UA1ZDC/StepDrive/StepDrivePwr/SDP_v1.1/Project Outputs for SDP_2/Bill/SDP_BOM.xlsx

Description | Designator | Footprint | Quantity | Value | Part Number
SMD Capacitor | C1, C7, C8, C9, C10, C13, C14, C17, C25, C29, C31, C32, C33 | C0603 | 13 | 0.1uF | GCJ188R71H104KA12D
SMD Capacitor | C2 | C1210 | 1 | 4.7uF | GRM188R61C475ME11D
SMD Capacitor | C2, C20, C21, C22, C23, C39, C40, C41, C42 | C1210 | 8 | 4.7uF | GRM32DC72A475KE01K
SMD Capacitor | C3 | C1210 | 1 | 10uF | GCM32EL8EH106KA07L
SMD Capacitor | C4, C5, C6 | C0603 | 3 | 1uF | GRT188R61H105KE13D
SMD Capacitor | C11, C12, C15, C16, C18, C19 | C0603 | 6 | 5600pF | GRM1885C1H562JA01D
SMD Capacitor | C24, C28, C30 | C0603 | 3 | 2200pF | GRM1885C1H222JA01D
SMD Capacitor | C26, C27 | C0603 | 2 | 100pF | GRM1885C1H101JA01J
SMD Capacitor | C34 | C0603 | 1 | 4.7nF | GCM188R91H472KA37D
SMD Capacitor | C35 | C0603 | 1 | 130pF | GRM1885C1H131JA01D
SMD Capacitor | C36 | C0603 | 1 | 8.2nF | GRM1885C1H822JA01D
SMD Capacitor | C37, C43, C44 | C0603 | 3 | 0.01uF | GCM188R71H103KA37J
SMD Capacitor | C38 | C0603 | 1 | 2.2uF | GRM188R61E225KA12J
SMD Capacitor | С20, C45, C46, C47 | C1210 | 4 | 10uF | GRM32EC72A106KE05
 | DD1 | DDA | 1 |  | TPS54332DDA
Regulator | DD2 | SOT23-5 | 1 |  | LP2985-33DBVR
Gate driver | DD3, DD4, DD5, DD6, DD8 | SO8_L | 5 |  | LM5109BMA
EEPROM | DD7 | SO8_L | 1 |  | AT25128B-SSHL-T
Shunt amplifier | DD9, DD10, DD11 | MSOP8 | 3 |  | AD8418WBRZ | или INA240A1D
fuse block | FU2 | omni_block_154 | 1 |  | 0154010.DR
LED0603 | HL1, HL2, HL3 | LED0603 | 3 |  | APT1608CGCK | green LED indicator
chip inductor | L1 | XAL5050 | 1 |  | XAL5050-223ME
 | L2, L3, L4, L5 | R0603 | 4 | 600 | BLM18AG601BH1D
SMD Resistor | R1 | R0603 | 1 | 68k | ERJ-3EKF6802V
SMD Resistor | R2, R6, R14, R15, R16, R17, R24, R25, R26, R27, R30, R31, R46, R49 | R0603 | 14 | 10k | ERJ-3EKF1002V
SMD Resistor | R3, R7 | R0603 | 2 | 22k | ERJ-3EKF2202V
SMD Resistor | R4, R34, R39, R42, R45, R47 | R0603 | 6 | 1k | ERJ-3EKF1001V
SMD Resistor | R5, R32, R37 | R0603 | 3 | 100 | ERJ-3EKF1000V
SMD Resistor | R8, R9, R10, R11, R12, R13, R18, R19, R20, R21, R22, R23, R28, R29 | R0603 | 14 | 2r2 | ERJ-PA3J2R2V
SMD Resistor | R33, R38, R51, R52 | R0603 | 4 | 0 | ERJ-S030R00V
SMD Resistor | R35, R36, R40, R41, R43, R44 | R2512 | 6 | 0.015 | ERJ-M1WSF15MU
SMD Resistor | R48 | R0603 | 1 | 10k5 | ERJ-3EKF1052V
SMD Resistor | R50 | R0603 | 1 | 750 | ERJ-3GEYJ751V
Shottky diode | VD1 | SMA-DO214 | 1 |  | B320A-13-F
zener diode | VD2 |  |  |  | BZX384C4V7-E3-08
zener diode | VD8, VD9, VD10, VD11 | SOD323 | 4 |  | BZX384B13-E3-08
Shottky rectifier | VD3, VD4, VD5, VD6, VD7 | SOD-123 | 5 |  | SKL110
 | VD12 |  | 1 |  | SM15T68A
MOSFET-N | VT1, VT2, VT3, VT4, VT5, VT6, VT7, VT8, VT9 | TDSON-8 | 9 |  | BSC030N08NS5ATMA1
pcb terminal | X1 | IDC-30(BH-30) | 1 |  | BH-30
pcb terminal | X2, X3 | 15EDGRC | 2 |  | ECH381RR-04P | 15EDGRC-3.81-04P
cable terminal |  |  | 2 |  | EC381V-04P | 15EDGK-3.81-04P
pcb terminal | X4 | DG308-2.54-2 | 1 |  | EK254V-02P
