UA1ZDC/StepDrive/StepDriveCont/SDC_v1.1/Docs/SDC_v1.1_Bill.xlsx

№ n/n | Type | Comment | Description | Designator | LibRef | Footprint | Name | PartNumber | Quantity | Value | Voltage
1 | Ceramic Capacitor | CAP | SMD Capacitor | C1, C10, C11, C12, C13, C14, C15, C16, C17, C18, C19, C20, C21, C22, C23, C24, C25, C26, C28, C31, C32, C33, C36, C37, C38, C39, C40, C41, C43, C46, C47, C48, C49, C50, C52, C53, C54, C55, C56, C57, C58, C59, C60, C61, C62, C63, C64, C66, C67, C70, C71, C79, C80, C81, C82, C86, C94, C96, C97, C98, C99, C100 | CAP | C0603 |  |  | 62 | 0.1uF | 50V
2 | Ceramic Capacitor | CAP | SMD Capacitor | C2, C9 | CAP | C0603 |  | GRM188R61A475KE15D | 2 (9шт) | 4.7uF | 10V
3 | Aluminum | KR-5R5H155-R | Ionistor | C3 | KR-5R5H155-R | KR-5R5H155-R |  |  | 1 | 1.5F | 5V
4 | Ceramic Capacitor | CAP | SMD Capacitor | C4 | CAP | C0603 |  |  | 1 | 10nF | 10V
5 | Ceramic Capacitor | CAP | SMD Capacitor | C5, C6 | CAP | C0603 |  |  | 2 | 2.2uF | 50V
6 | Ceramic Capacitor | CAP | SMD Capacitor | C7, C8, C34, C35 | CAP | C0603 |  |  | 4 | 5.6pF | 50V
7 | Ceramic Capacitor | CAP | SMD Capacitor | C27, C42, C44 | CAP | C0603 |  |  | 3 | 4.7uF | 50V
8 | Ceramic Capacitor | CAP | SMD Capacitor | C29 | CAP | C0603 |  |  | 1 | 1nF | 50V
9 | Ceramic Capacitor | CAP | SMD Capacitor | C30, C65 | CAP | C0603 |  |  | 2 | 1uF | 50V
10 | Ceramic Capacitor | CAP | SMD Capacitor | C45, C51 | CAP | C1206 |  |  | 2 | 47uF | 10V
11 | Ceramic Capacitor | CAP | SMD Capacitor | C68, C69 | CAP | C0603 |  |  | 2 | NC | 10V
12 |  | caseD | Polarized Capacitor (Surface Mount) | C72, C73, C92, C93 | Cap Pol_D | Cap_D |  |  | 4 | 22uF | 35V
13 | Ceramic Capacitor | CAP | SMD Capacitor | C74, C75 | CAP | C1210 |  |  | 2 | 10uF | 50V
14 | Ceramic Capacitor | CAP | SMD Capacitor | C76 | CAP | C0603 |  |  | 1 | 10nF | 50V
15 | Ceramic Capacitor | CAP | SMD Capacitor | C77, C84, C95 | CAP | C1210 |  |  | 3 | 10uF | 10V
16 | Ceramic Capacitor | CAP | SMD Capacitor | C78, C85 | CAP | C1210 |  |  | 2 | 47uF | 10V
17 | Ceramic Capacitor | CAP | SMD Capacitor | C83 | CAP | C0603 |  |  | 1 | 0.47uF | 50V
18 | Ceramic Capacitor | CAP | SMD Capacitor | C87, C101 | CAP | C0805 |  |  | 2 | 10uF | 50V
19 | Ceramic Capacitor | CAP | SMD Capacitor | C88, C102 | CAP | C1210 |  |  | 2 | 22uF | 25V
20 | Ceramic Capacitor | CAP | SMD Capacitor | C89, C103 | CAP | C0603 |  |  | 2 | 4.7nF | 50V
21 | Ceramic Capacitor | CAP | SMD Capacitor | C90, C104 | CAP | C0603 |  |  | 2 | 130pF | 50V
22 | Ceramic Capacitor | CAP | SMD Capacitor | C91, C105 | CAP | C0603 |  |  | 2 | 8.2nF | 50V
23 |  | USBLC6 | ESD protection Very low capacitance | DA1 | USBLC6-4SC6 | ESD_SOT23-6L |  | USBLC6-4SC6Y | 1 (3шт)
24 |  | STM32H743ZxT | ARM Cortex-M7, 480MHz, 32-bit MCU+FPU, 144-pin LQFP | DD1 | STM32H743ZxT | STM-LQFP144_L |  | STM32H743ZIT6U | 1 (2шт)
25 |  | SIM68V | GPS module | DD2 | SIM68V | SIM68M |  |  | 1
26 |  | LIS3DH | Accelerometer | DD3 | LIS3DH | LGA-16 |  |  | 1
27 |  | KXO-V97 | KXO generator | DD4, DD5 | KXO-V97 | SO4-GEN |  |  | 2
28 |  | LAN8742A | RMII 10/100 Ethernet PHY | DD6 | LAN8742A | QFN-MJ24 |  | LAN8742A-CZ | 1 (3 шт)
29 |  | 74HC245PWR, 74LVC45APWR |  | DD7, DD9 | 74HC245PWR, 74LVC45APWR | TSSOP20 |  |  | 2
30 |  | ADM2587E | RS485 isolator | DD8 | ADM2587E | SOIC_20W |  |  | 1
31 |  | STM3485 | RS485_tranciever | DD10 | ST3485EB | SO8_L |  |  | 1
32 |  | TMC4671 | Motion_controller | DD11, DD12 | TMC4671 | QFN76 |  |  | 2
33 |  | Si8660BA-IS, AM26C31CD, AM26LV32ID, 74HC257 | digital isolator, RS-422 transmitter, RS-422 receiver, MUX | DD13, DD15, DD17, DD18, DD19 | Si8660BA-IS, AM26C31CD, AM26LV32ID, 74HC257 | SO-16_N |  |  | 5
34 | Industrial eFuse | TPS26600RHFR | Industrial eFuse | DD14 | TPS26600RHFR | VQFN24 | TPS26600 |  | 1 |  | 60V
35 |  | LM26420X |  | DD16 | LM26420X | WQFN16 |  |  | 1
36 |  | TPS54332 |  | DD20, DD21 | TPS54332 | DDA |  |  | 2
37 |  | TBU-CA065 | TBU fuse | F1, F2, F3, F4, F5, F6 | TBU-CA065 | TBU-CA |  |  | 6
38 |  | 0154010 | omni fuse block | FU1 | 0154010 | omni_block_154 |  |  | 1
39 |  | 2030-42T-SM | Charger | FV1, FV2, FV3 | 2030-42T-SM | 2030-42T-SM |  |  | 3
40 |  | LED0603 | LED0603 | HL1, HL2, HL3, HL4, HL5 | LED0603 | LED0603 |  |  | 5
41 |  | JUMP |  | J1, J2 | JUMP | JUMP |  |  | 2
42 |  | LQH32CN | chip inductor | L1, L3, L4 | LQH32CN | LQH32CN |  |  | 3 | 1uH
43 |  | FerriteBead | SMD Chip ferrite bead 0603 | L2 | FerriteBead | L0603 |  |  | 1 | 600R
44 |  | BLM18AG |  | L5 | BLM18AG | R0603 |  |  | 1 | 600
45 |  | XAL6060 | chip inductor | L6 | XAL6060 | XAL6060 |  |  | 1
46 |  | XAL4030 | chip inductor | L7, L8 | XAL4030 | XAL4030 |  |  | 2 | 3.3uH
47 |  | XAL5050 | chip inductor | L9, L10 | XAL5050 | XAL5050 |  |  | 2 | 5.1uH
48 |  | NX2016SA | Crystal oscillator 25MHz | Q1 | NX2016SA | CRY_NX2016SA_4P |  | NX2016SA | 1 (6шт) | 25MHz
49 |  | RES | SMD Resistor | R1, R2, R3, R4, R8, R16, R21, R22, R23, R30, R31, R37, R38, R39, R40, R41, R42, R45, R46, R47, R48, R49, R50, R51, R52 | RES | R0603 | Chip SMD Resistor | RC0603FR-0710KL | 25 (9шт) | 10k
50 |  | RES | SMD Resistor | R5, R6, R7, R24, R65, R66 | RES | R0603 | Chip SMD Resistor |  | 6 | 1k5
51 |  | RES | SMD Resistor | R9 | RES | R0603 | Chip SMD Resistor |  | 1 | 27k
52 |  | RES | SMD Resistor | R10, R11, R12, R55, R61, R64 | RES | R0603 | Chip SMD Resistor |  | 6 | 1k
53 |  | RES | SMD Resistor | R13, R14, R15, R25, R26, R27, R34 | RES | R0603 | Chip SMD Resistor |  | 7 | 33
54 |  | RES | SMD Resistor | R17, R18, R19, R20 | RES | R0603 | Chip SMD Resistor |  | 4 | 51
55 |  | RES | SMD Resistor | R28, R43, R44, R72, R73, R74, R75, R76 | RES | R0603 | Chip SMD Resistor | RC0603JR-070RL | 8 (162) | 0 | не уверена
56 |  | RES | SMD Resistor | R29 | RES | R0603 | Chip SMD Resistor |  | 1 | 12k1
57 |  | RES | SMD Resistor | R32, R33 | RES | R0603 | Chip SMD Resistor |  | 2 | 270
58 |  | RES | SMD Resistor | R35, R36 | RES | R0603 | Chip SMD Resistor | RC0603FR-07100KL | 2 (12шт) | 100 | не уверена
59 |  | RES | SMD Resistor | R53 | RES | R0603 | Chip SMD Resistor |  | 1 | 221k
60 |  | RES | SMD Resistor | R54 | RES | R0603 | Chip SMD Resistor |  | 1 | 8k87
61 |  | RES | SMD Resistor | R56, R60, R63, R69, R78 | RES | R0603 | Chip SMD Resistor |  | 5 | 10k2
62 |  | RES | SMD Resistor | R57 | RES | R0603 | Chip SMD Resistor |  | 1 | 6k04
63 |  | RES | SMD Resistor | R58 | RES | R0603 | Chip SMD Resistor |  | 1 | 5.1
64 |  | RES | SMD Resistor | R59 | RES | R0603 | Chip SMD Resistor |  | 1 | 31k6
65 |  | RES | SMD Resistor | R62 | RES | R0603 | Chip SMD Resistor |  | 1 | 5k1
66 |  | RES | SMD Resistor | R67 | RES | R0603 | Chip SMD Resistor |  | 1 | 665k
67 |  | RES | SMD Resistor | R68, R77 | RES | R0603 | Chip SMD Resistor |  | 2 | 9k31
68 |  | RES | SMD Resistor | R70 | RES | R0603 | Chip SMD Resistor |  | 1 | 316k
69 |  | RES | SMD Resistor | R71 | RES | R0603 | Chip SMD Resistor |  | 1 | 1k96
70 |  | RES | SMD Resistor | R79 | RES | R0603 | Chip SMD Resistor |  | 1 | 750
71 |  | Test_point |  | TP1, TP2, TP3, TP4, TP5, TP6, TP7, TP8, TP9, TP10, TP11, TP12, TP13, TP14, TP15, TP16, TP17, TP18, TP19, TP20, TP21, TP22, TP23, TP24 | TP | TP1 |  |  | 24
72 |  | SMBJ | TVS diode, TVSdiode | VD1, VD2, VD3, VD4, VD5, VD6, VD7, VD8, VD9 | SMBJ5CA, SMBJ12CA | SMB-DO214 |  |  | 9
73 |  | B550C | DIODE, SCHOTTKY, 5A, 50V, SMC | VD10 | B550C | SMC-DO214 |  |  | 1
74 |  | ESDA6V1SC6, ESDA5V3SC6 | 4-line ESD protection | VD11, VD12, VD13, VD14, VD16, VD17, VD18, VD19 | ESDA6V1SC6, ESDA5V3SC6 | SOT23-6 |  | USBLC6-2SC6Y | 8 (3 шт) |  | не уверена
75 |  | B320A | Shottky diode | VD15, VD20 | B320A | SMA-DO214 |  |  | 2
76 |  | IRLML2803 | n-channel fet | VT1, VT2 | IRLML2803 | SOT23 |  | BSR14 | 2 (12 шт)
77 |  | BH-20 |  | X1 | IDC10x2_GOST | IDC-20(BH-20) |  |  | 1
78 |  | MMCX | Coaxial | X2 | MMCX | MMCX |  |  | 1
79 |  | HR911105A |  | X3 | HR911105A | HR911105A |  |  | 1
80 |  | DG141V-6P | wire connector | X4, X9, X10, X11, X12, X13, X14 | DG141V-6P | DG141V-06P |  |  | 7
81 |  | DG141V-12P | wire connector | X5 | DG141V-12P | DG141V-12P |  |  | 1
82 |  | BH-30 |  | X6, X7 | IDC15x2_GOST | IDC-30(BH-30) |  |  | 2
83 |  | DG142V-02 |  | X8 | DG142V-02 | DG142V-02 |  |  | 1
84 |  | FC-12M | Crystal_32_768 | Z1 | FC-12M | FC-12M |  |  | 1
