UA1ZDC/StepDrive/StepDrivePwr/SDP_v1.1/SDP.PcbDoc.htm

Reporting Options

# File in Previous Format

Date | : | 08.12.2022
Time | : | 16:05:46
Filename | : | D:\Altium_Projects\StepDrive\StepDrivePwr\SDP_v1.1\SDP.PcbDoc

Version | Warning

This file was generated by an earlier version of the software
