UA1ZDC/StepDrive/StepDriveCont/SDC_v1.1/SDC.PcbDoc.htm

Reporting Options

# File in Previous Format

Date | : | 08.12.2022
Time | : | 15:32:59
Filename | : | D:\Altium_Projects\StepDrive\StepDriveCont\SDC_v1.1\SDC.PcbDoc

Version | Warning

This file was generated by an earlier version of the software
