UA1ZDC/StepDrive/StepDriveCont/SDC_v1.1/Docs/KRJ-CB4.2GYZNL.docx

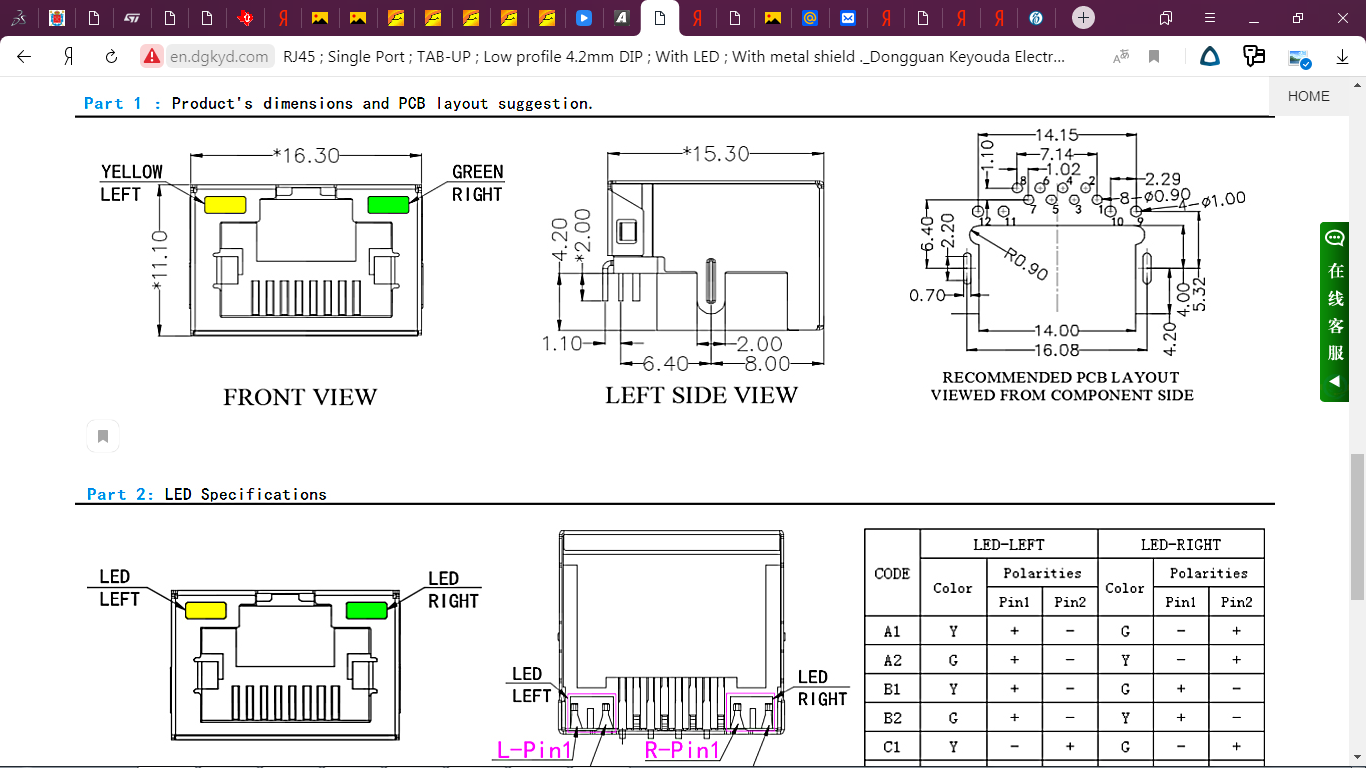
[picture p1: figure]
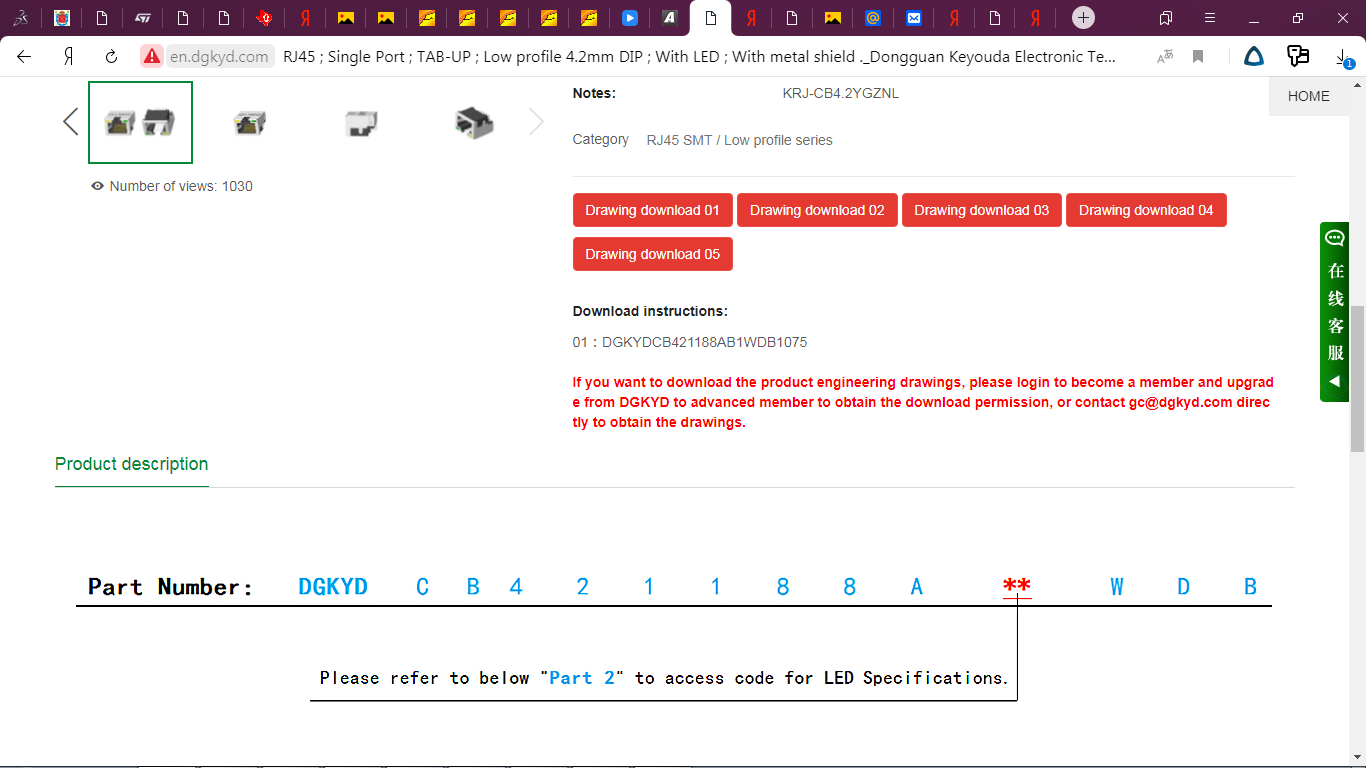
[picture p2: figure]
