UA1ZDC/StepDrive/StepDriveCont/SDC_v1.0/SDC.PcbDoc.htm

Reporting Options

# File in Previous Format

Date | : | 13.01.2022
Time | : | 19:52:07
Filename | : | D:\Altium_Projects\StepDrive\StepDriveCont\SDC.PcbDoc

Version | Warning

This file was generated by an earlier version of the software
