UA1ZDC/StepDrive/StepDriveCont/SDC_v1.0/Project Outputs for SDC/Бланк заказа.xlsx

Резонит тел. +7-495-777-80-80 e-mail: pcb@rezonit.ru
Название фирмы (или ФИО) заказчика |  |  |  |  | Овчинников Юрий Дмитриевич
Тип собственности плательщика |  |  |  |  | Физическое лицо
ФИО плательщика (если различно с заказчиком)
Серия, номер паспорта. Кем и когда выдан
Способ отправки счета |  |  |  |  | Электронная почта |  |  |  |  |  | email | yurii_ovchinniko@mail.ru
Способ получения плат |  |  |  |  | Самовывоз из офиса в Санкт-Петербурге
Способ доставки |  |  |  |  | необходимо заполнить
Адрес доставки заказа, примечания по доставке |  |  |  |  | необходимо заполнить
Контакт по доставке (ФИО, email, тел) |  |  |  |  | Овчинников Юрий Дмитриевич, yurii_ovchinniko@mail.ru, +7 (981) 197-43-18
Контакт по техническим вопросам (ФИО, email, тел) |  |  |  |  | Конюшенко Игорь Олегович, igorek1980@mail.ru, +7 (921) 932-28-17
Характеристика проекта |  |  |  |  | поля заполнены типовыми значениями, при необходимости можете изменить их
Название файла платы: |  |  |  |  | SDС |  |  |  |  |  | Срок производства ОПП и ДПП без маски — 2 рабочих дня, с маской — 3 дня. Срок производства многослойных печатных плат – 5-7 рабочих дней 1. Наличие электротестирования, иммерсионного золочения, нестандартной паяльной маски увеличивает срок изготовления на 1—2 рабочих дня. 2. Дни приема и доставки заказа не учитываются. 3. Изготовление плат по 5-му классу точности добавляет к сроку изготовления 1—2 рабочих дня. Отдельно оплачивается: • Иммерсионное золочение и иммерсионное сереберение • Нестандартная (черная, красная, синяя или супербелая) защитная маска +1500 руб. • Покрытие ламелей: Au — 0,30 руб./мм², Ni — 0,05 руб./мм². • Проверка платы электротестовым оборудованием на КЗ и обрыв — 40 руб./дм². • Изготовление и электротестирование 1 дм² МПП плат с параметрами зазор и/или проводник менее 0,2 мм, и/или минимальное переходное отверстие менее 0,4 мм, коэффициент = 1,2. • Изготовление и электротестирование 1 дм² ДПП с параметрами зазор и/или проводник менее 0,15 мм, и/или минимальное переходное отверстие менее 0,3 мм, коэффициент = 1,5.
Плата изготавливается: "впервые" / "повторно" |  |  |  |  | впервые
Вариант изготовления |  |  |  |  | Срочное производство
Требуется изготовить, шт |  |  |  |  | 2
Количество проводящих слоев |  |  |  |  | 4
Материал основания |  |  |  |  | FR4 типовой
Толщина материала (ОПП, ДПП)/Общая толщина платы ( МПП), мм |  |  |  |  | 1.50
Толщина фольги, мкм |  |  |  |  | 18
Финишное покрытие площадок |  |  |  |  | ПОС-63
Наличие маски |  |  |  |  | маска с 2 сторон |  |  | зеленого(типового)цвета
Наличие маркировки краской |  |  |  |  | с 2 сторон |  |  | белого(типового)цвета
Монтаж печатных плат |  |  |  |  | не требуется
Дополнительные требования
Перечень технологических слоев |  |  |  |  | поля заполнены типовыми значениями, при необходимости можете заполнить
 |  | Имя Gerber файла_Layer name (PCAD200x)_Слои в PCAD4.5(8.5)_DipTrace |  |  | Типовая сборка |  |  | Требуемая сборка |  | сверловка, укажите цветом начальный и конечный слой
Контур платы |  | SDС.GKO
Маркировка элементов сверху |  | SDС.GTO |  |  |  |  |  |  |  | Сквозные металлизированные отверстия | Сквозные неметаллизированные отверстия
Маска верхнего слоя |  | SDС.GTS
Верхний слой |  | SDС.GTL |  |  | фольга 18мкм
Внутренний
Внутренний
Внутренний
Внутренний |  | SDС.G1 |  |  | фольга 18мкм
Внутренний |  | SDС.G2 |  |  | фольга 18мкм
Внутренний
Внутренний
Внутренний
Нижний слой |  | SDС.GBL |  |  | фольга 18мкм
Маска нижнего слоя |  | SDС.GBS
Маркировка элементов снизу
PTH |  | SDС.txt
NPTH
Несквозные отверстия 1
Несквозные отверстия 2
Несквозные отверстия 3
Расширенные параметры печатной платы (сборка, мех. обработка и т.д) |  |  |  |  | поля заполнены типовыми значениями, при необходимости можете изменить их
Электротестирование
Покрытие краевых разъемов |  |  |  |  | соответствует финишному покрытию
Фаска 30грд на краевых разъемах
Мех обработка контура |  |  |  |  | На усмотрение производства
Металлизированный торец платы |  |  |  |  | Нет
Металлизированные полуотверстия
Металлизированные пазы
Структура МПП |  |  |  |  | типовая
Для PCAD4.5;8.5;2000 переходные |  |  |  |  | закрыты маской
Для экспорта шелкографии в PCAD200x мы используем след. настройки по умолчанию |  |  |  |  | RefDes | On | Type | Off | Value | Off
Панелизация |  |  |  |  | На усмотрение производтва
Размер платы (длина по горизонтали), мм |  |  |  |  | 100
Размер платы (ширина по вертикали), мм |  |  |  |  | 160
Количество плат по горизонтали
Количество плат по вертикали
Зазор между платами по горизонтали
Зазор между платами по вертикали
Размер полей по горизонтали
Размер полей по вертикали
Маркировка плат по ГОСТ
Описание PIN & VIA PCAD-4.5 и PCAD8.5.
Масштаб изготовления фотошаблона |  |  |  |  | 1:1
№ pin | Диаметр отверстия после металлизации | Размер контактной площадки | Форма контактной площадки | Наличие металлизации (по умолчению отверстия метализированы) | слои подключения (для многослоек)
