UA1ZDC/StepDrive/StepDriveCont/SDC_v1.1/Docs/HTB1oDgENVXXXXa2XXXXq6xXFXXXW.jpg

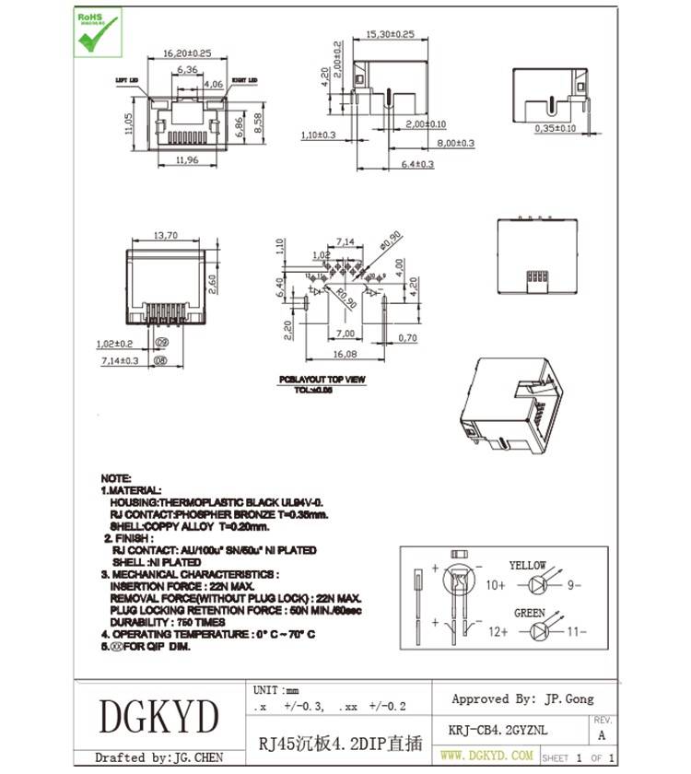
StepDriveCont/SDC_v1.1/Docs/HTB1oDgENVXXXXa2XXXXq6xXFXXXW.jpg
