UA1ZDC/StepDrive/StepDriveCont/SDC_v1.1/Docs/SDC_v1.1_assembly.PDF

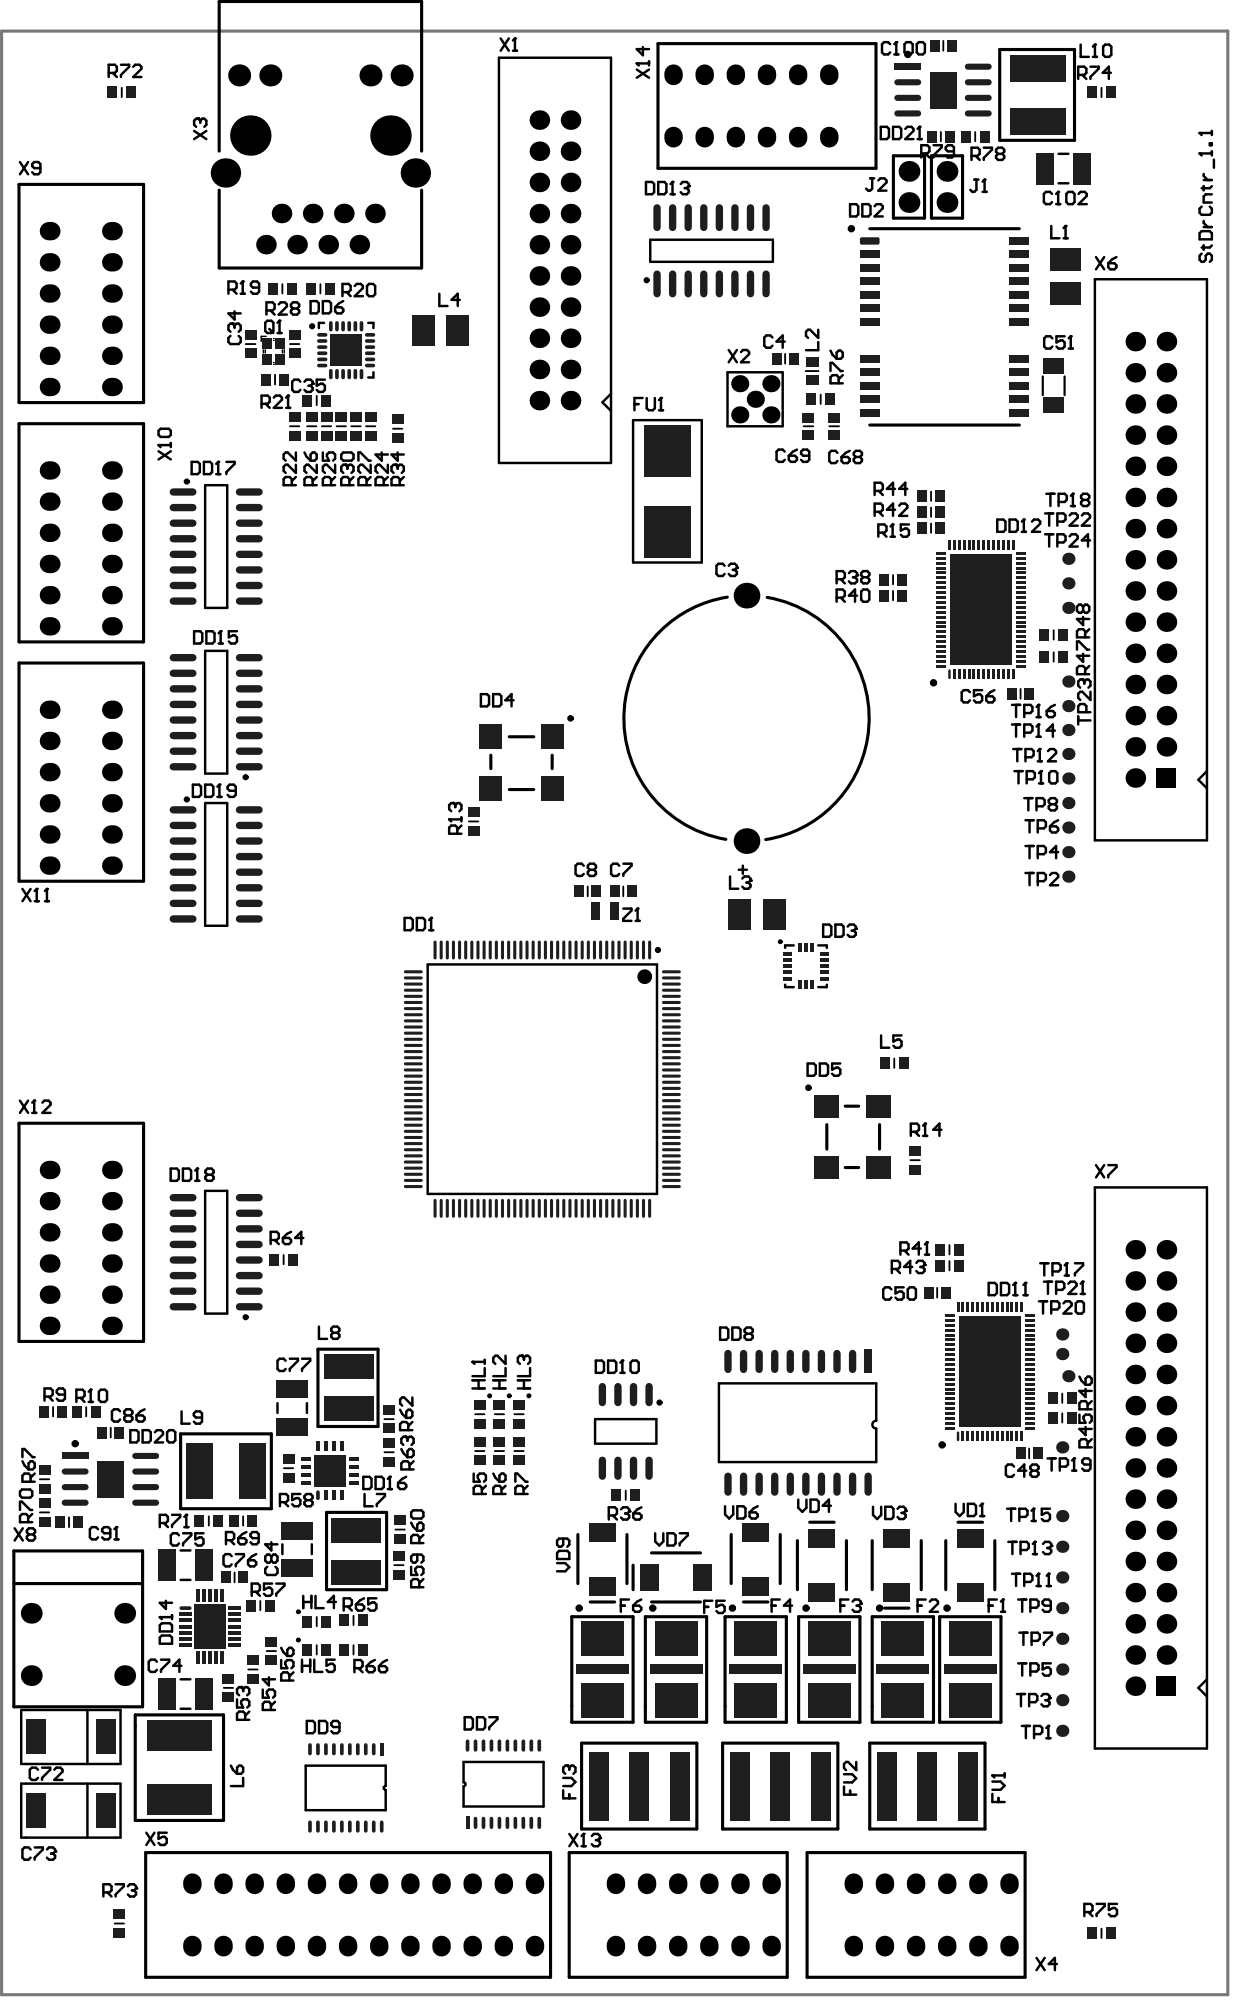
[picture p4: page 1]

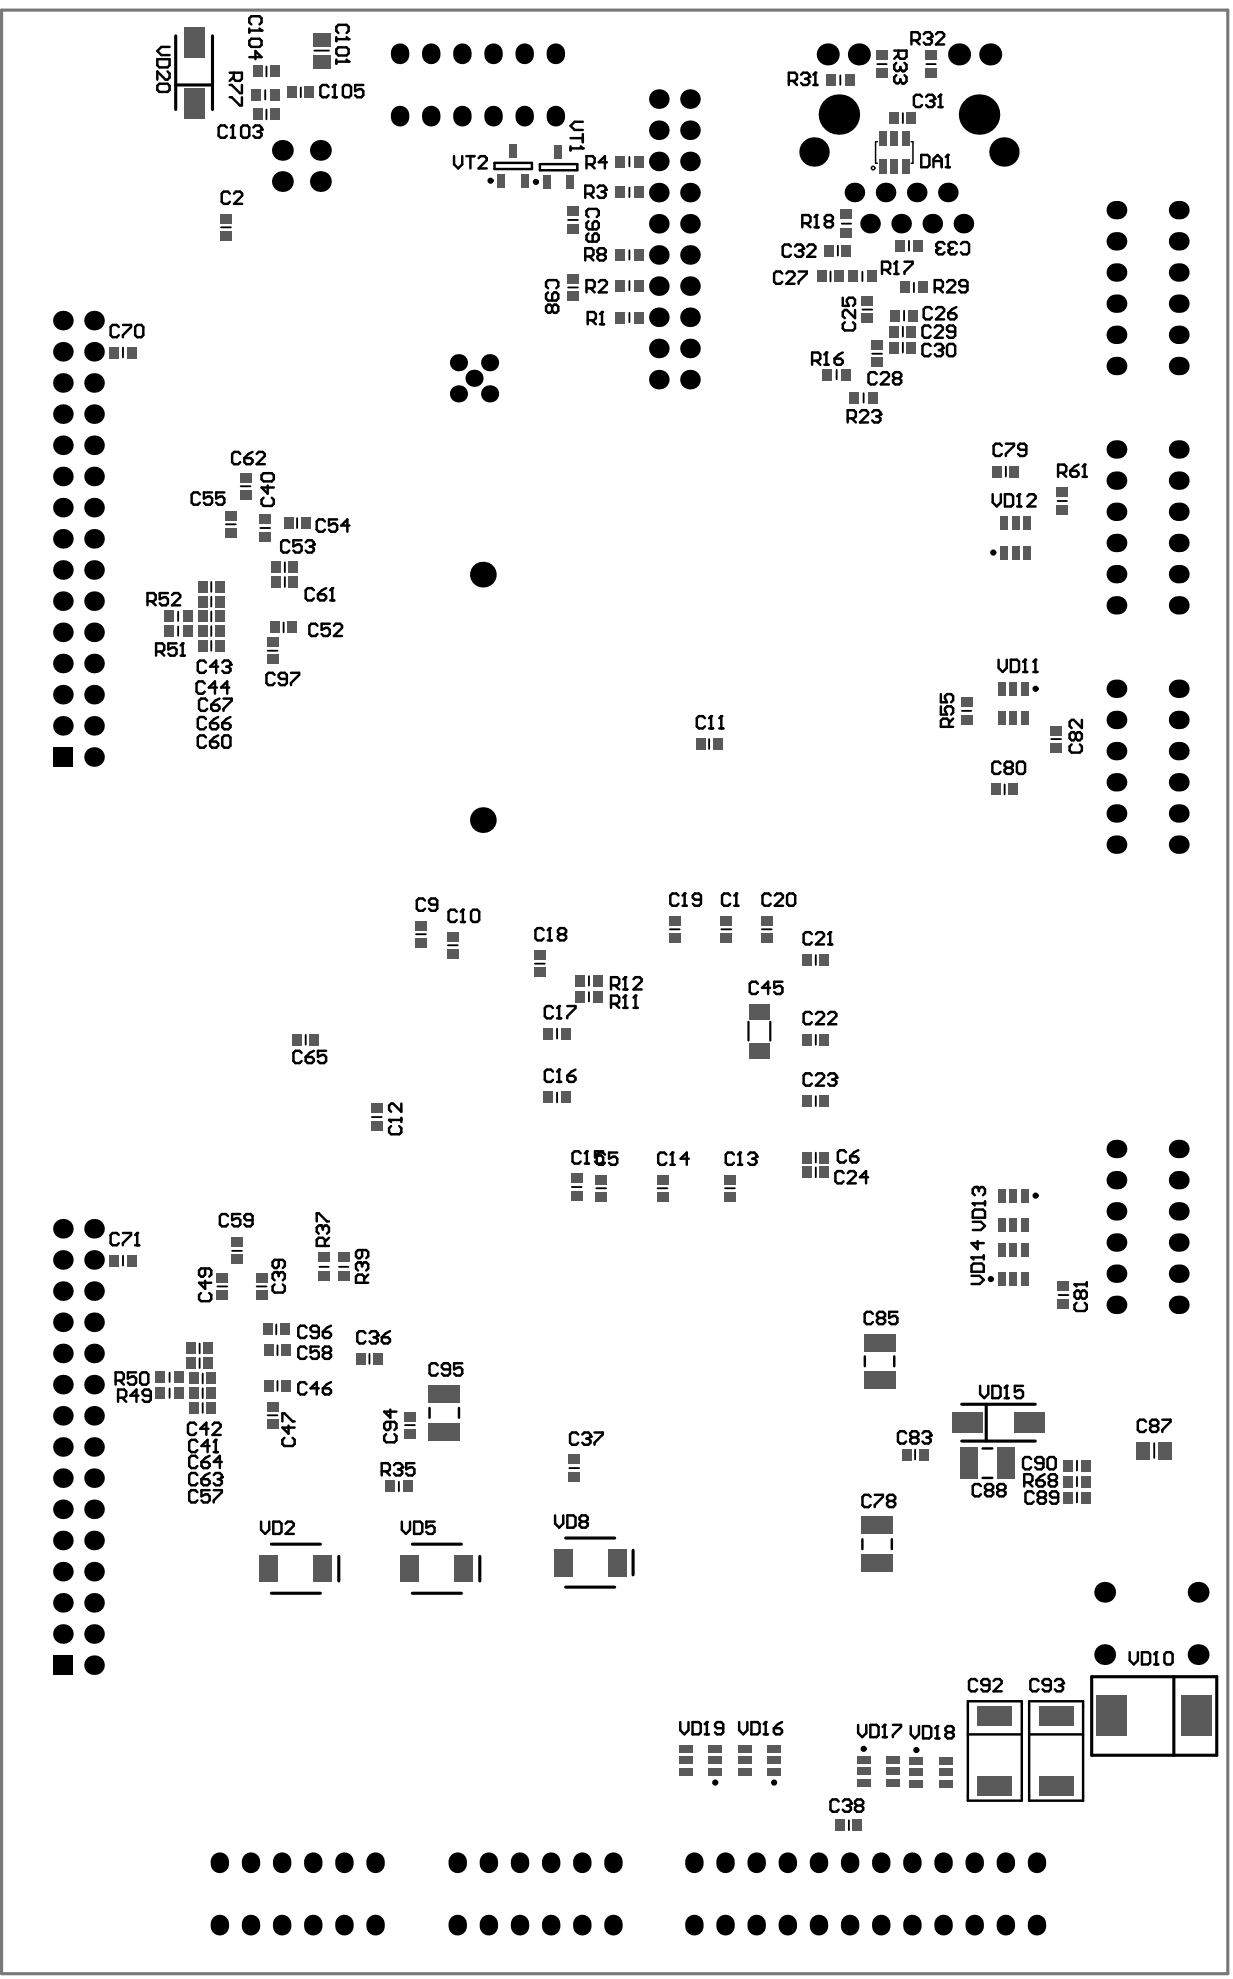
[picture p5: page 2]
