UA1ZDC/StepDrive/StepDrivePwr/SDP_v1.1/Project Outputs for SDP_2/PDF/StepPwr_v1.1_aseembly.PDF

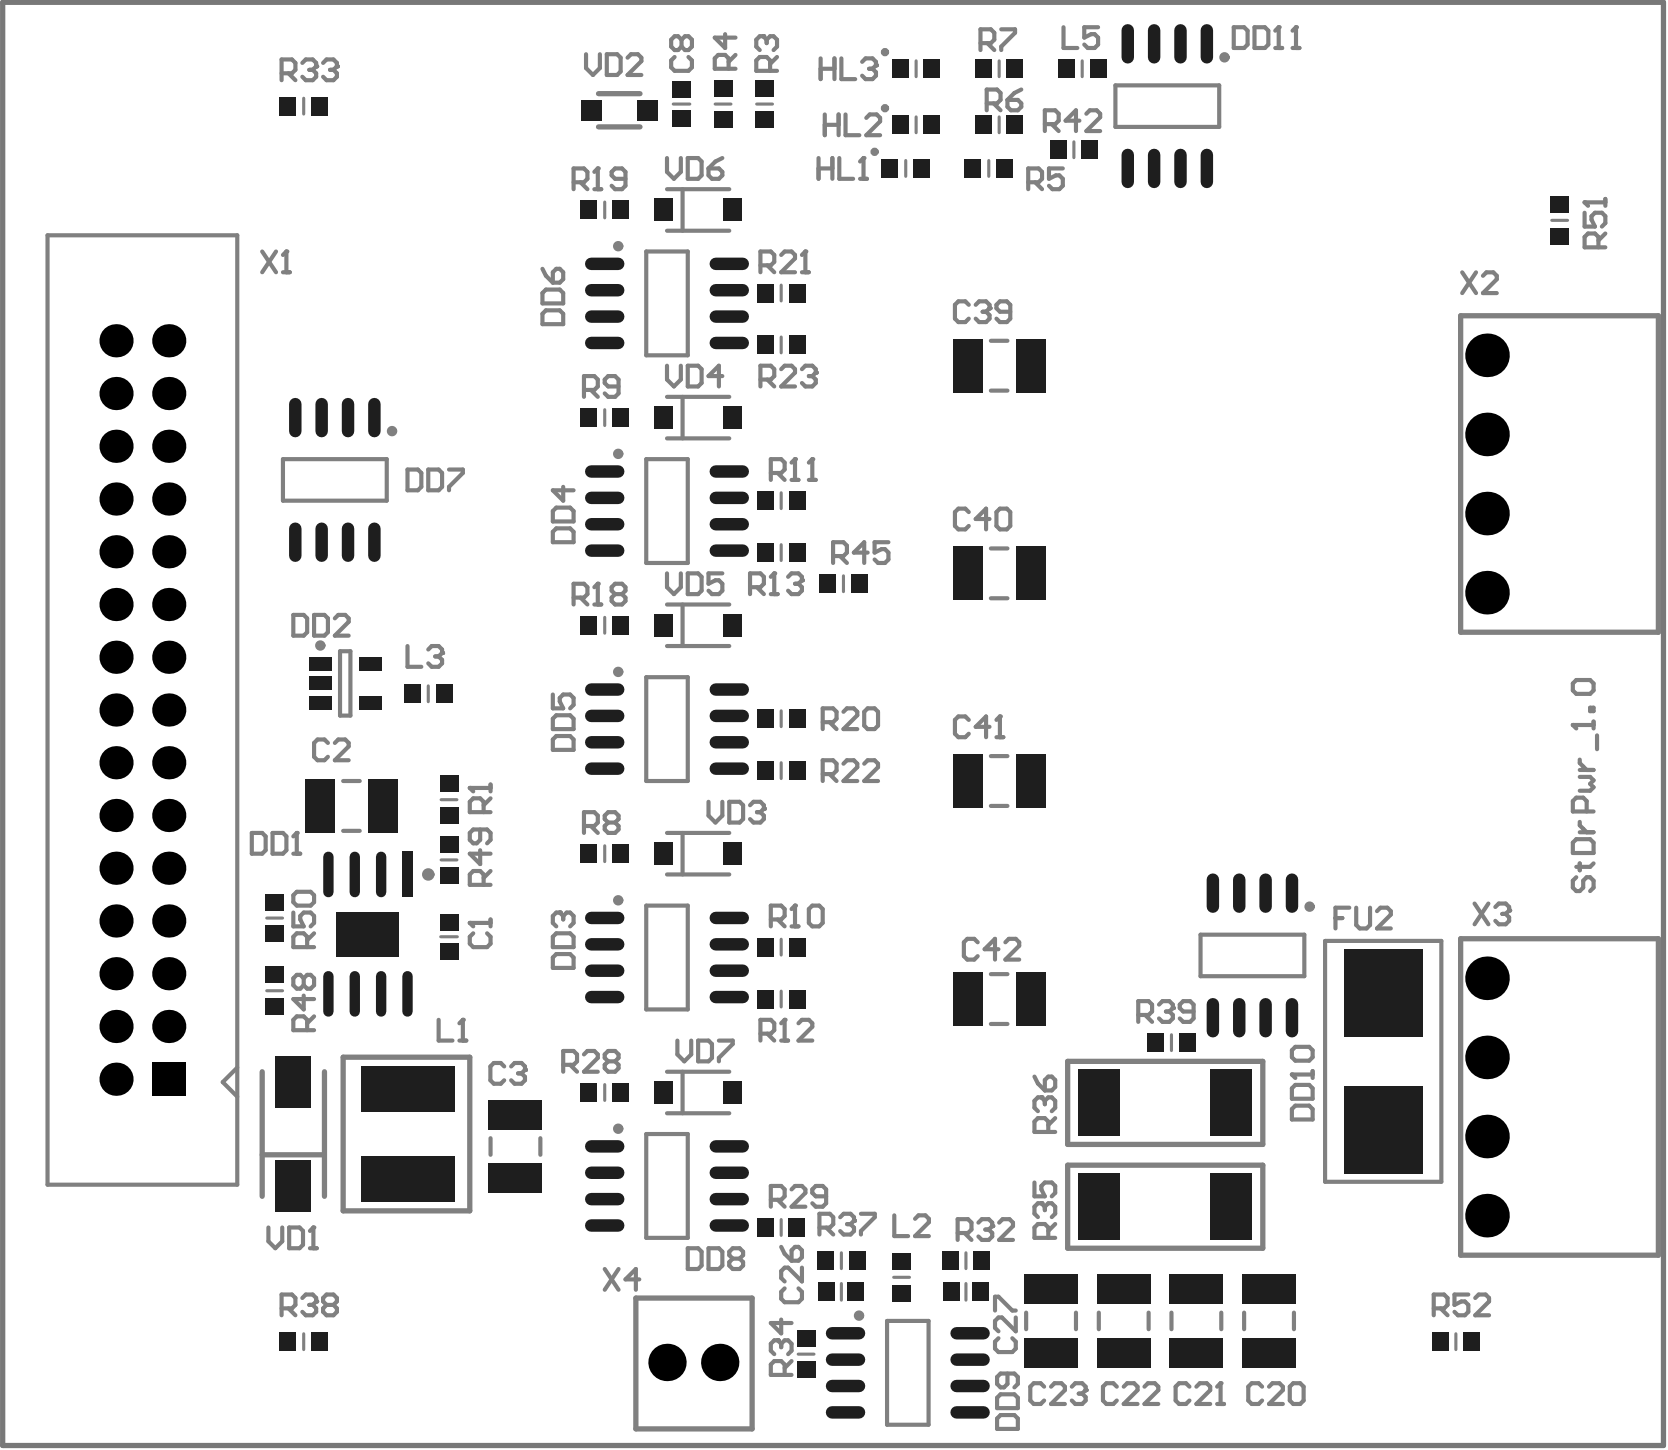
[picture p6: page 1]

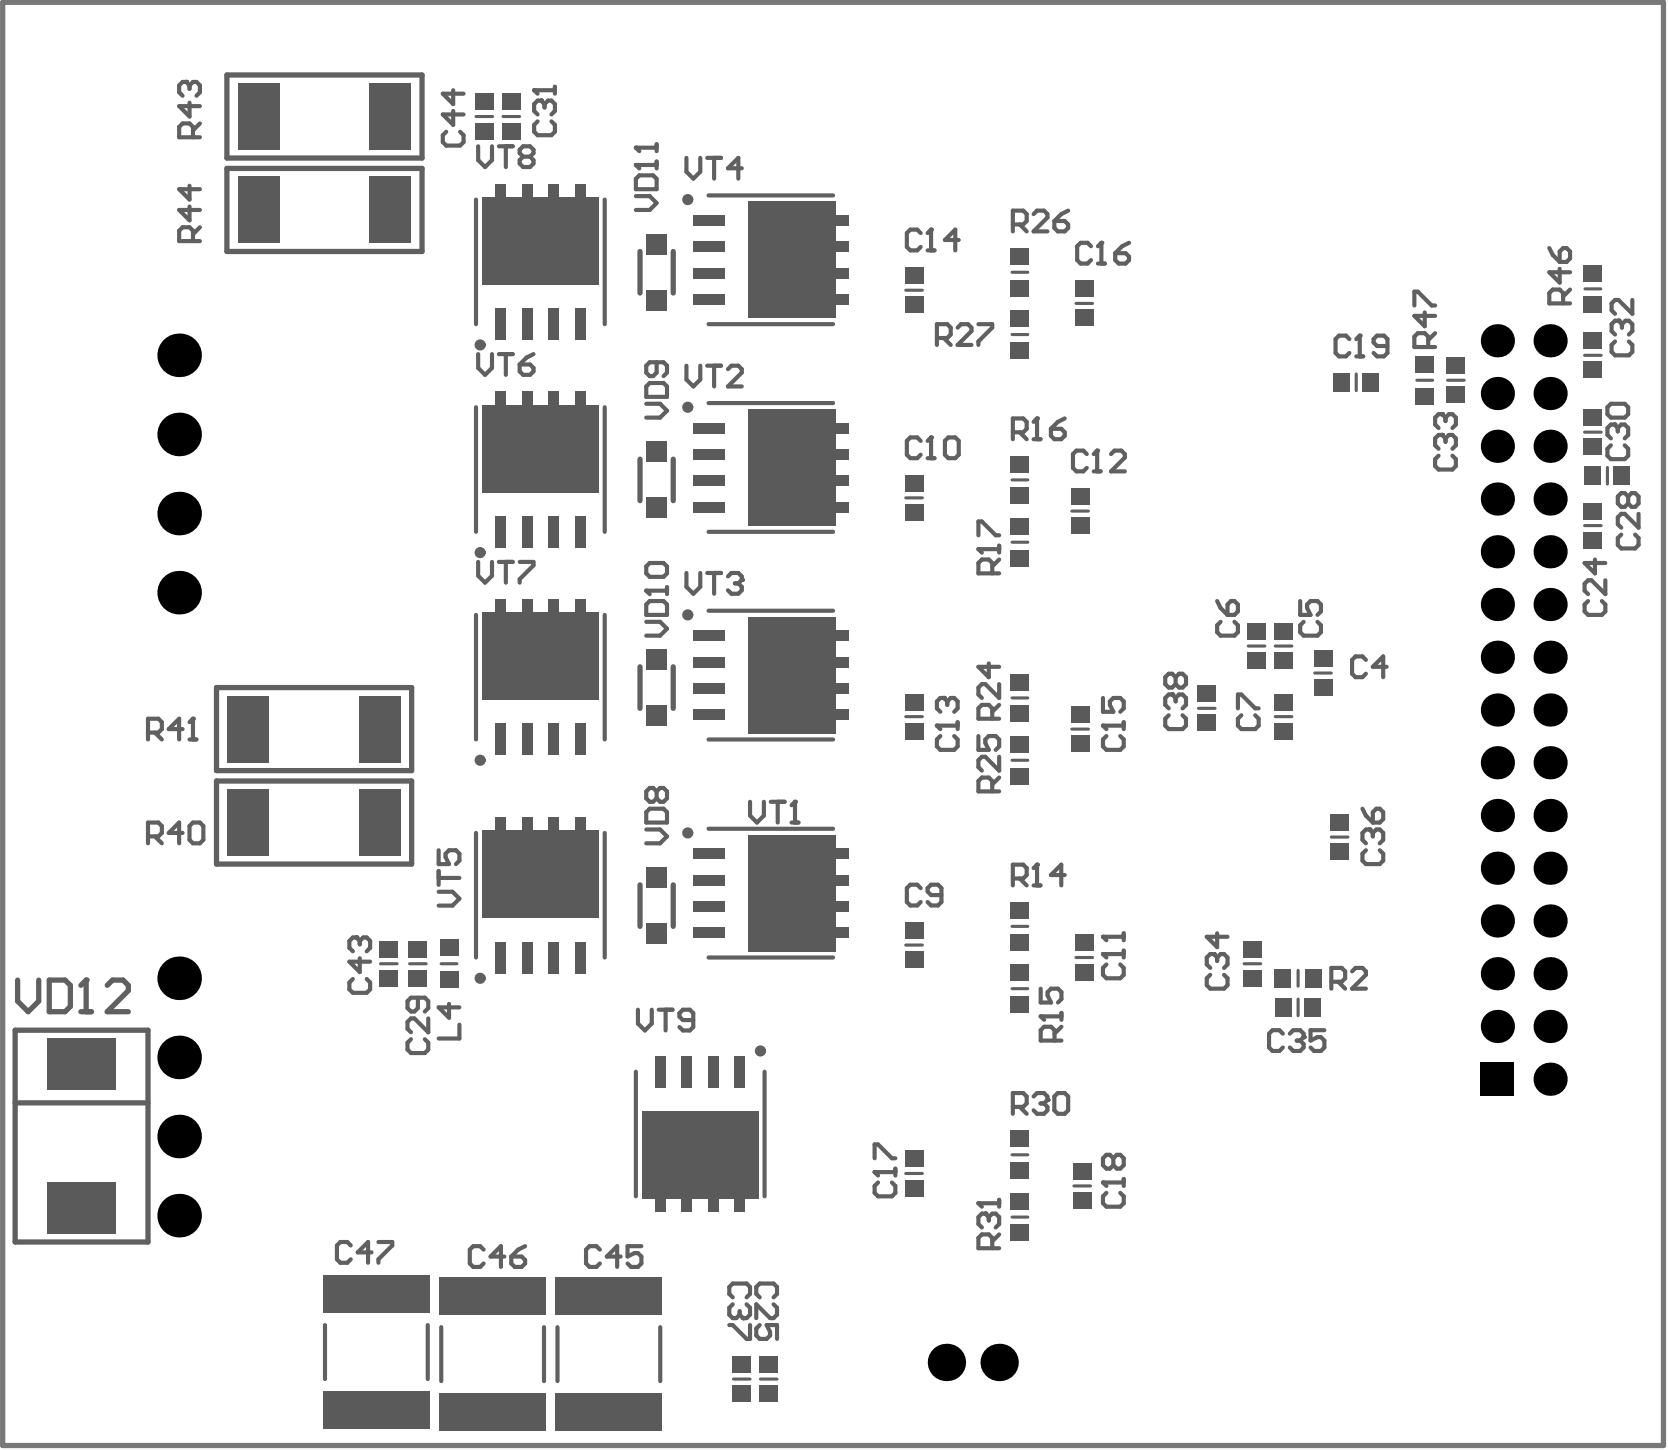
[picture p7: page 2]
