UA1ZDC/StepDrive/StepDrivePwr/SDP_v1.0/SDP.pdf

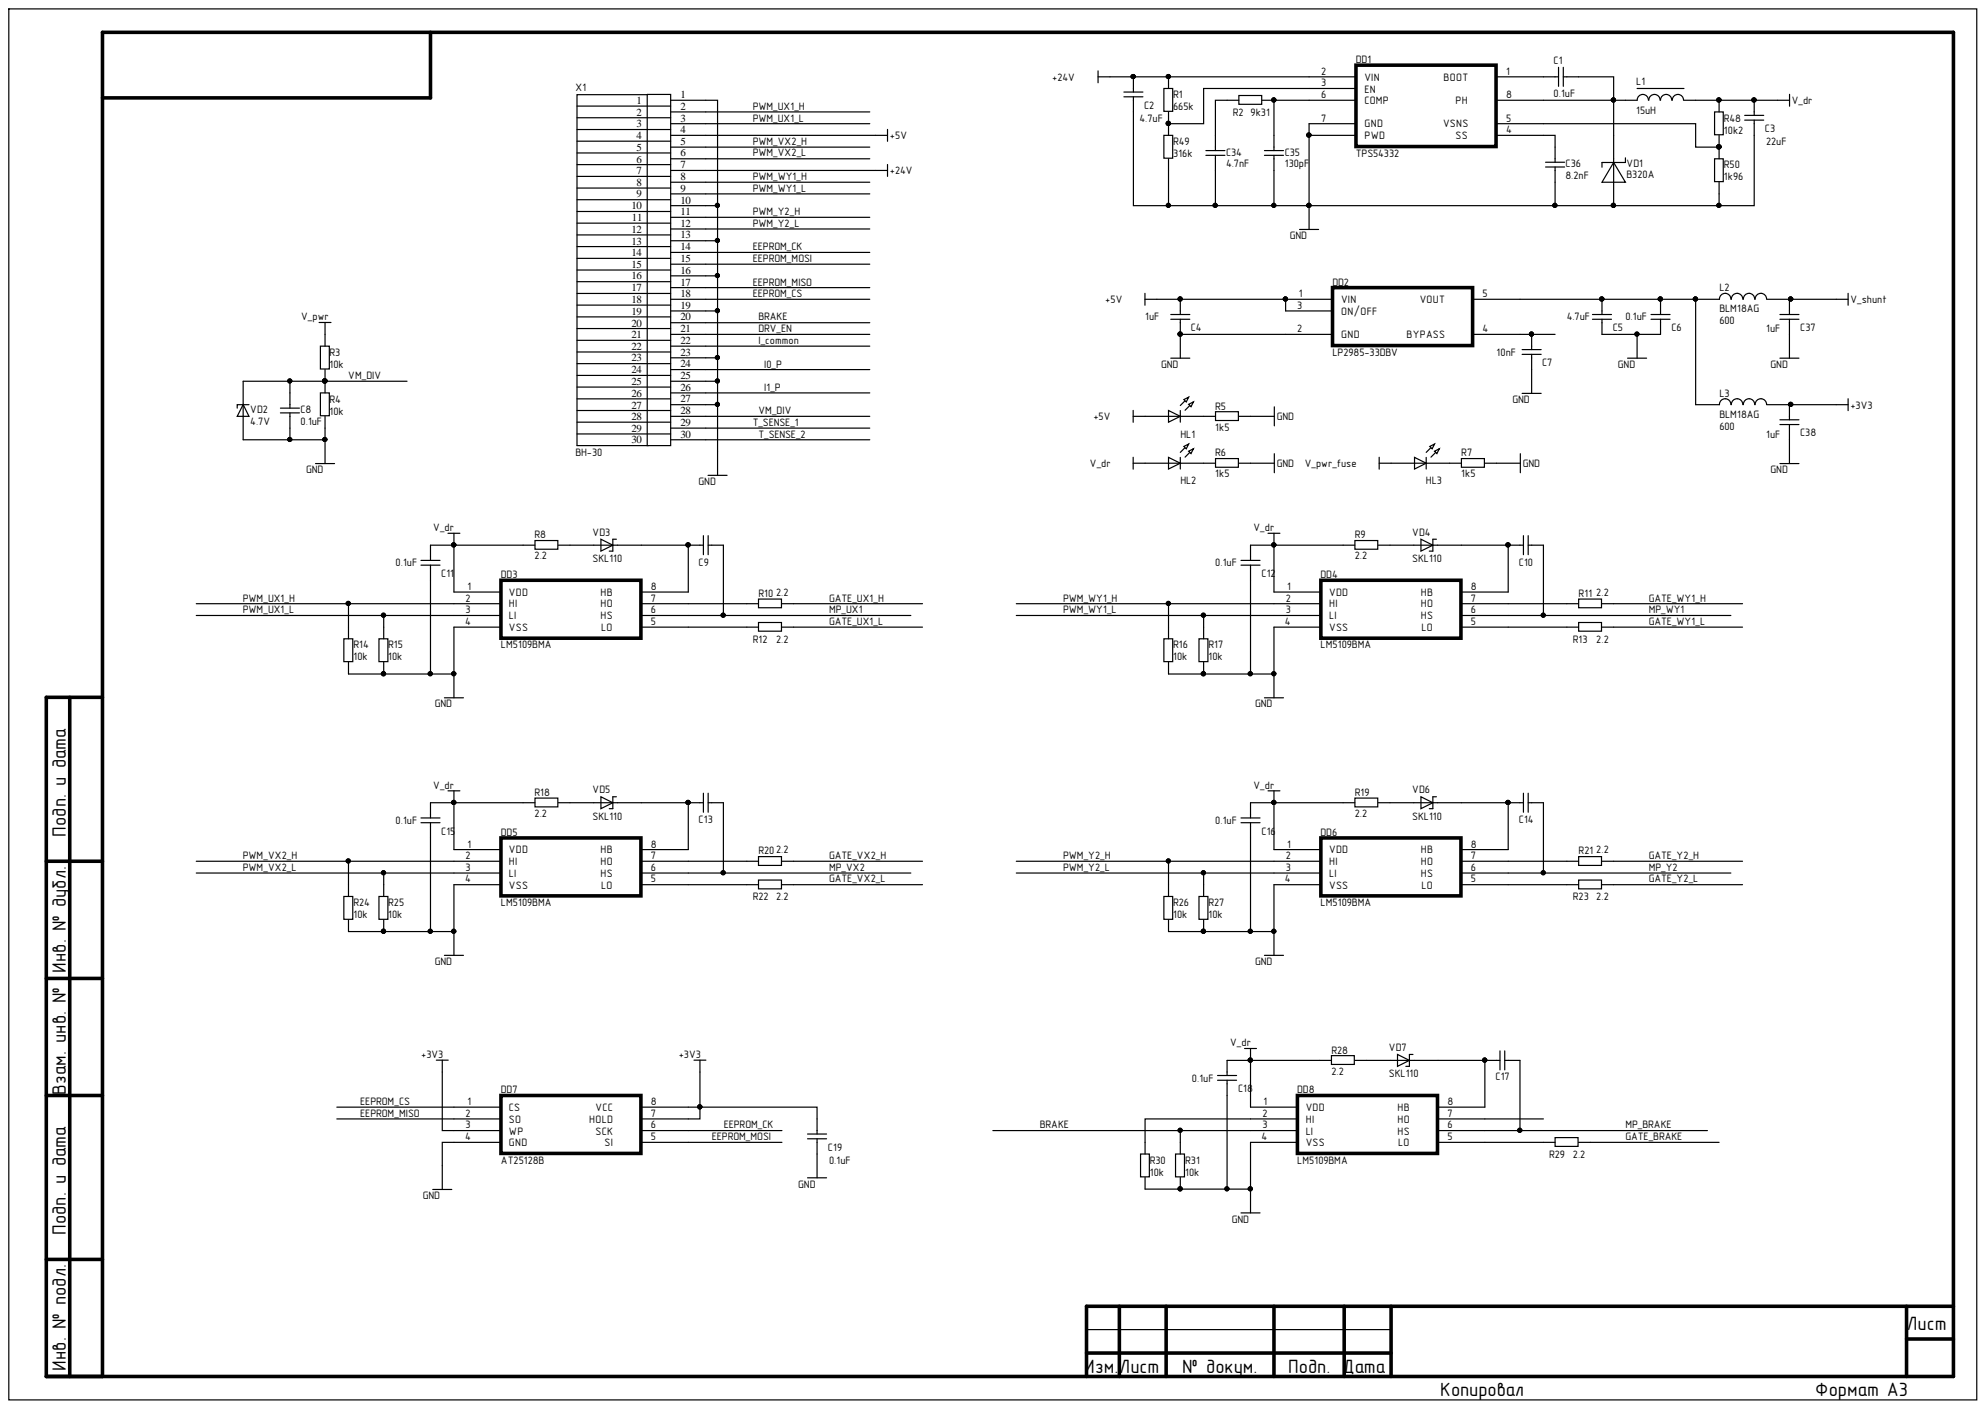
[picture p8: page 1]

EN 3
COMP 6 GND 7

Инв. № подл. Инв. № дубл. Подп. и дата Взам. инв. № Подп. и дата

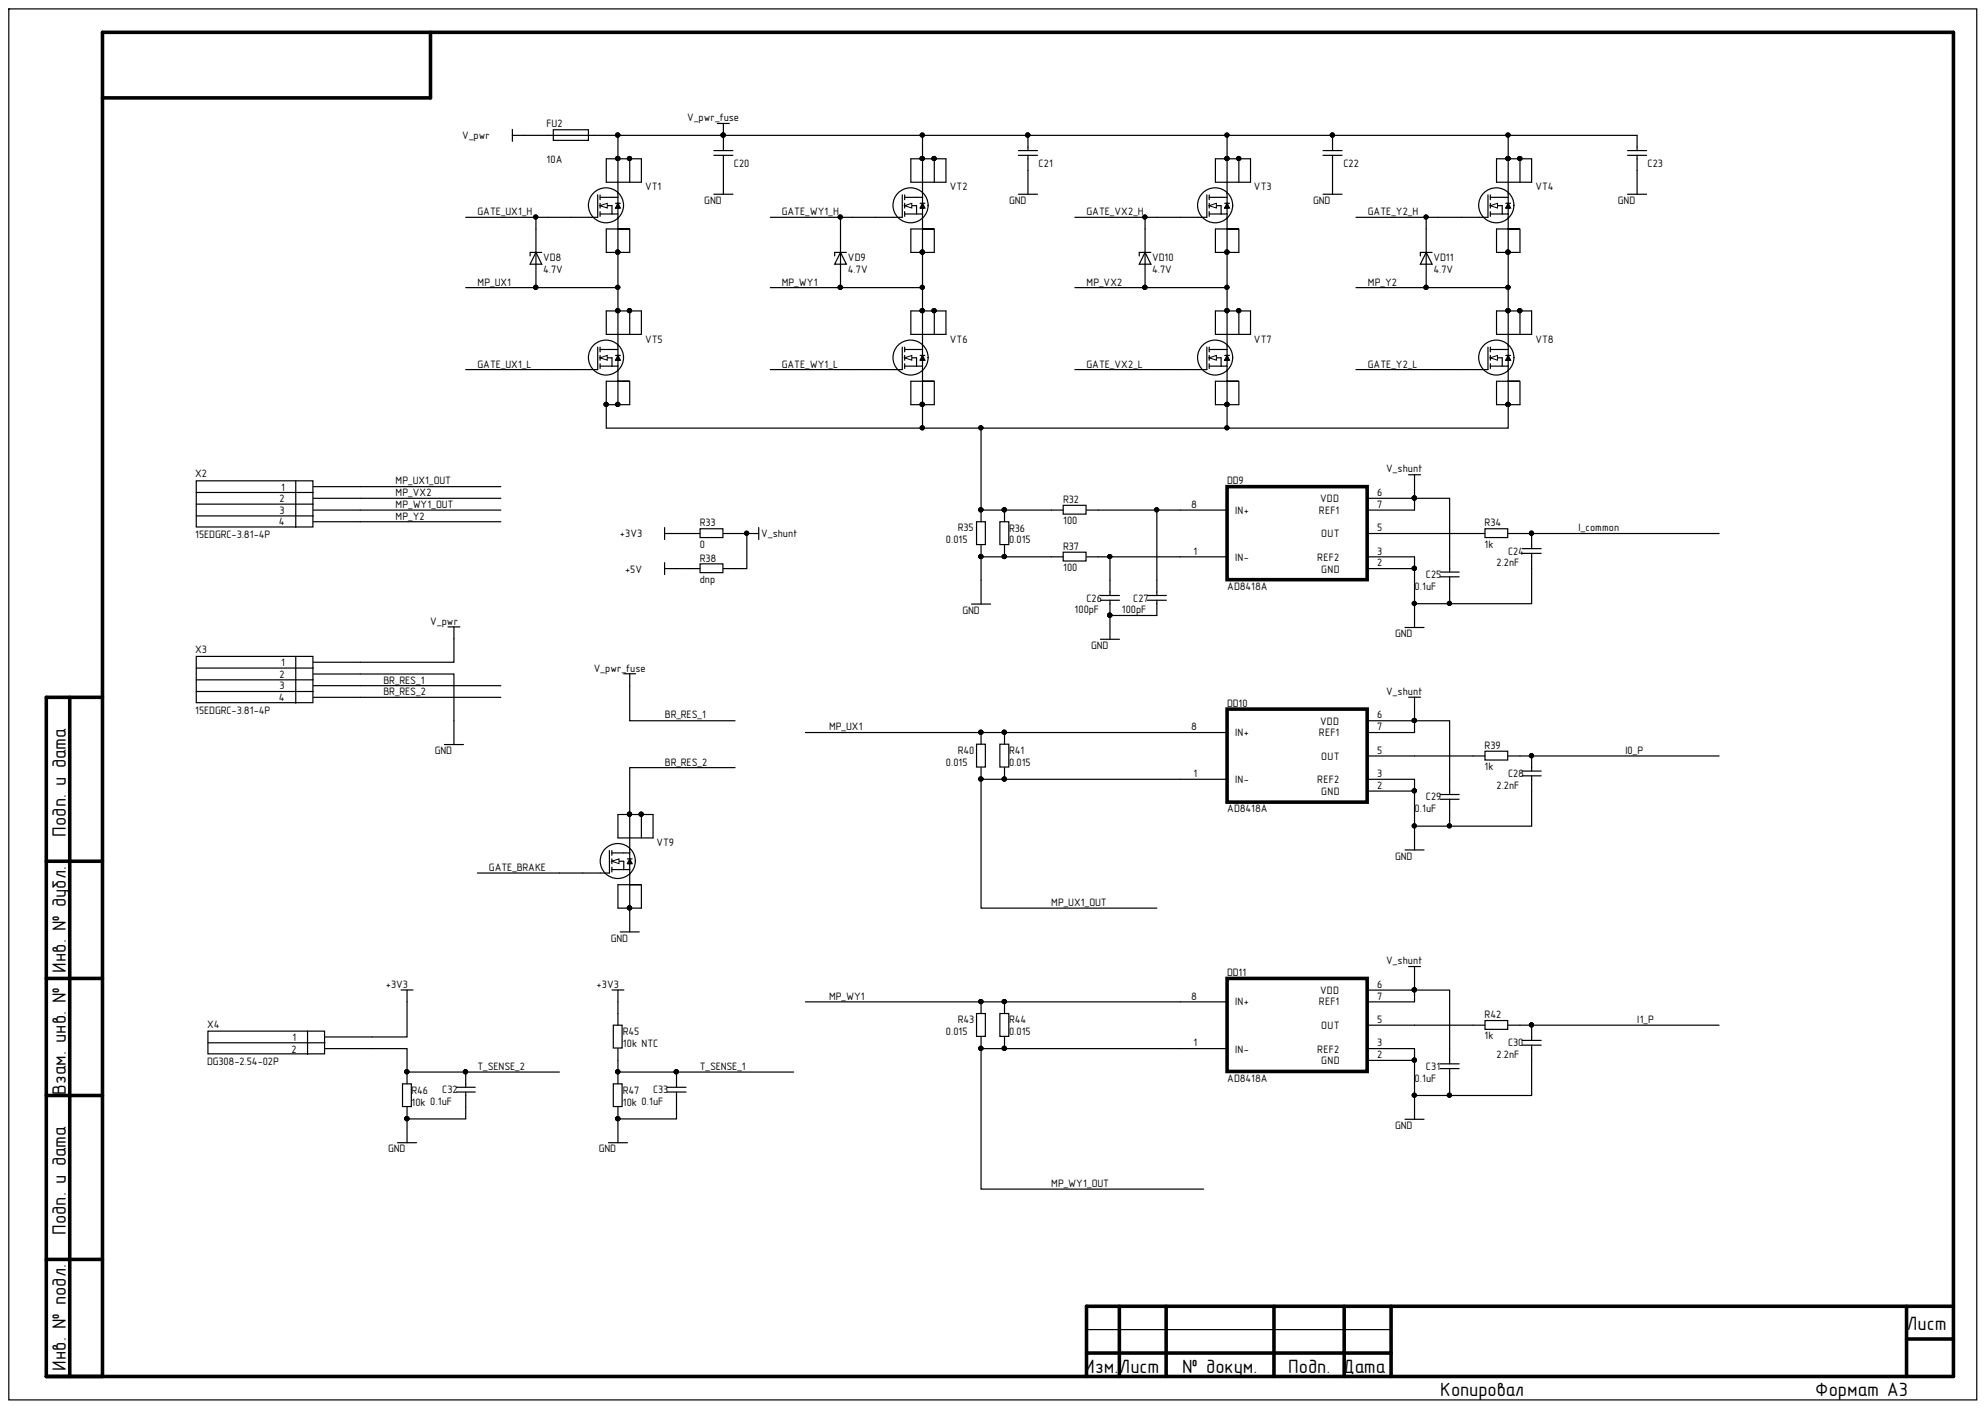
[picture p9: page 2]

2 | BR_RES_1 BR_RES_2

Инв. № подл. Инв. № дубл. Подп. и дата Взам. инв. № Подп. и дата
