UA1ZDC/StepDrive/StepDriveCont/SDC_v1.0/SDC.pdf

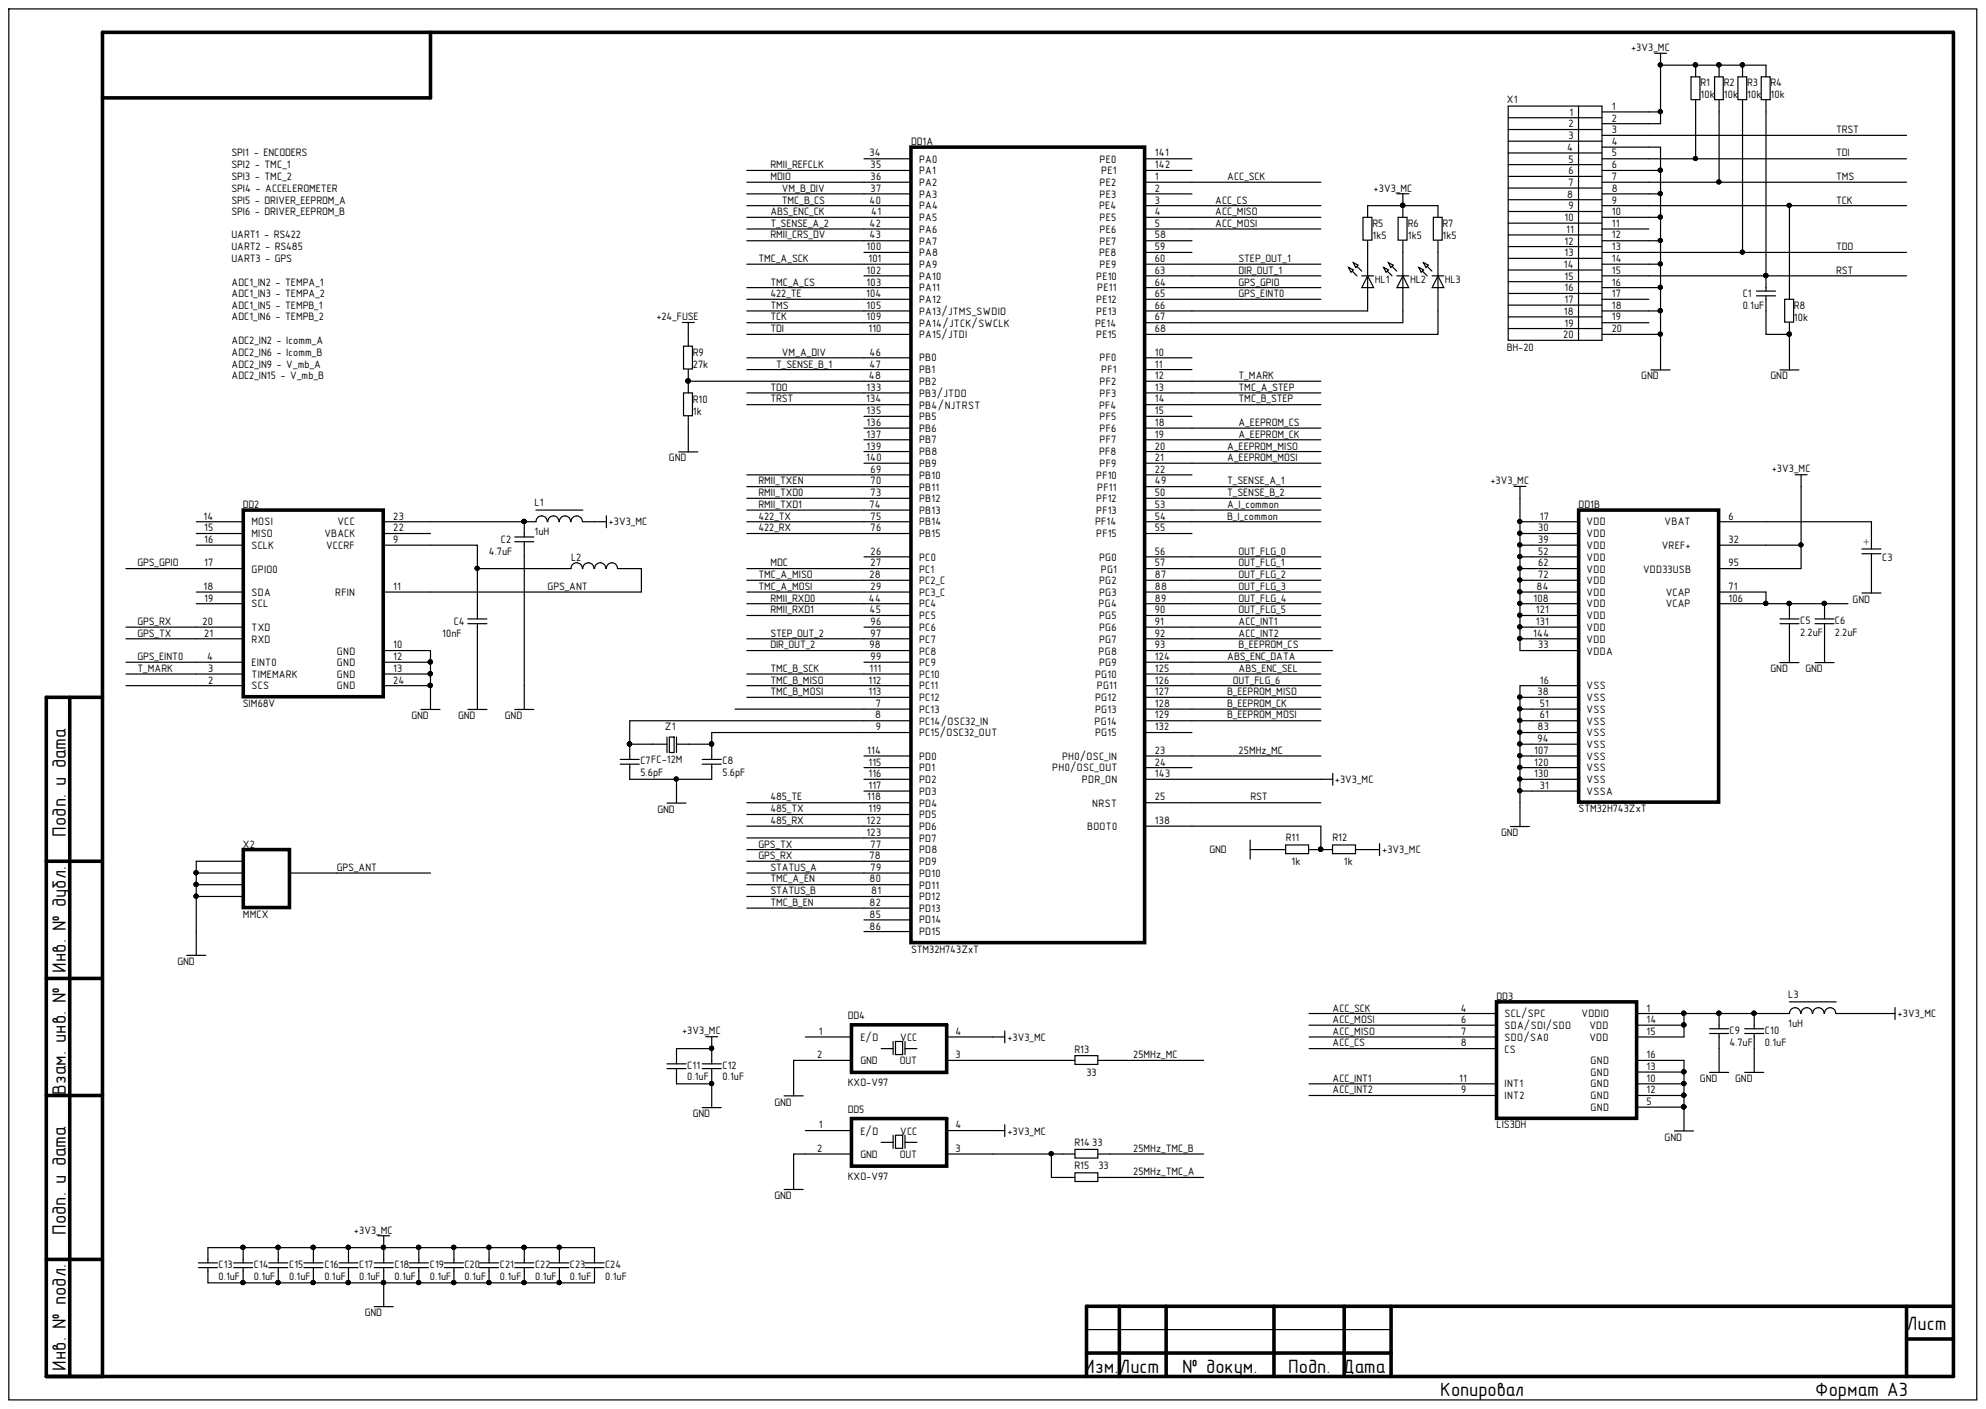
[picture p10: page 1]

TDI

18 | 18
19 | 19

Инв. № подл. Инв. № дубл. Подп. и дата Взам. инв. № Подп. и дата

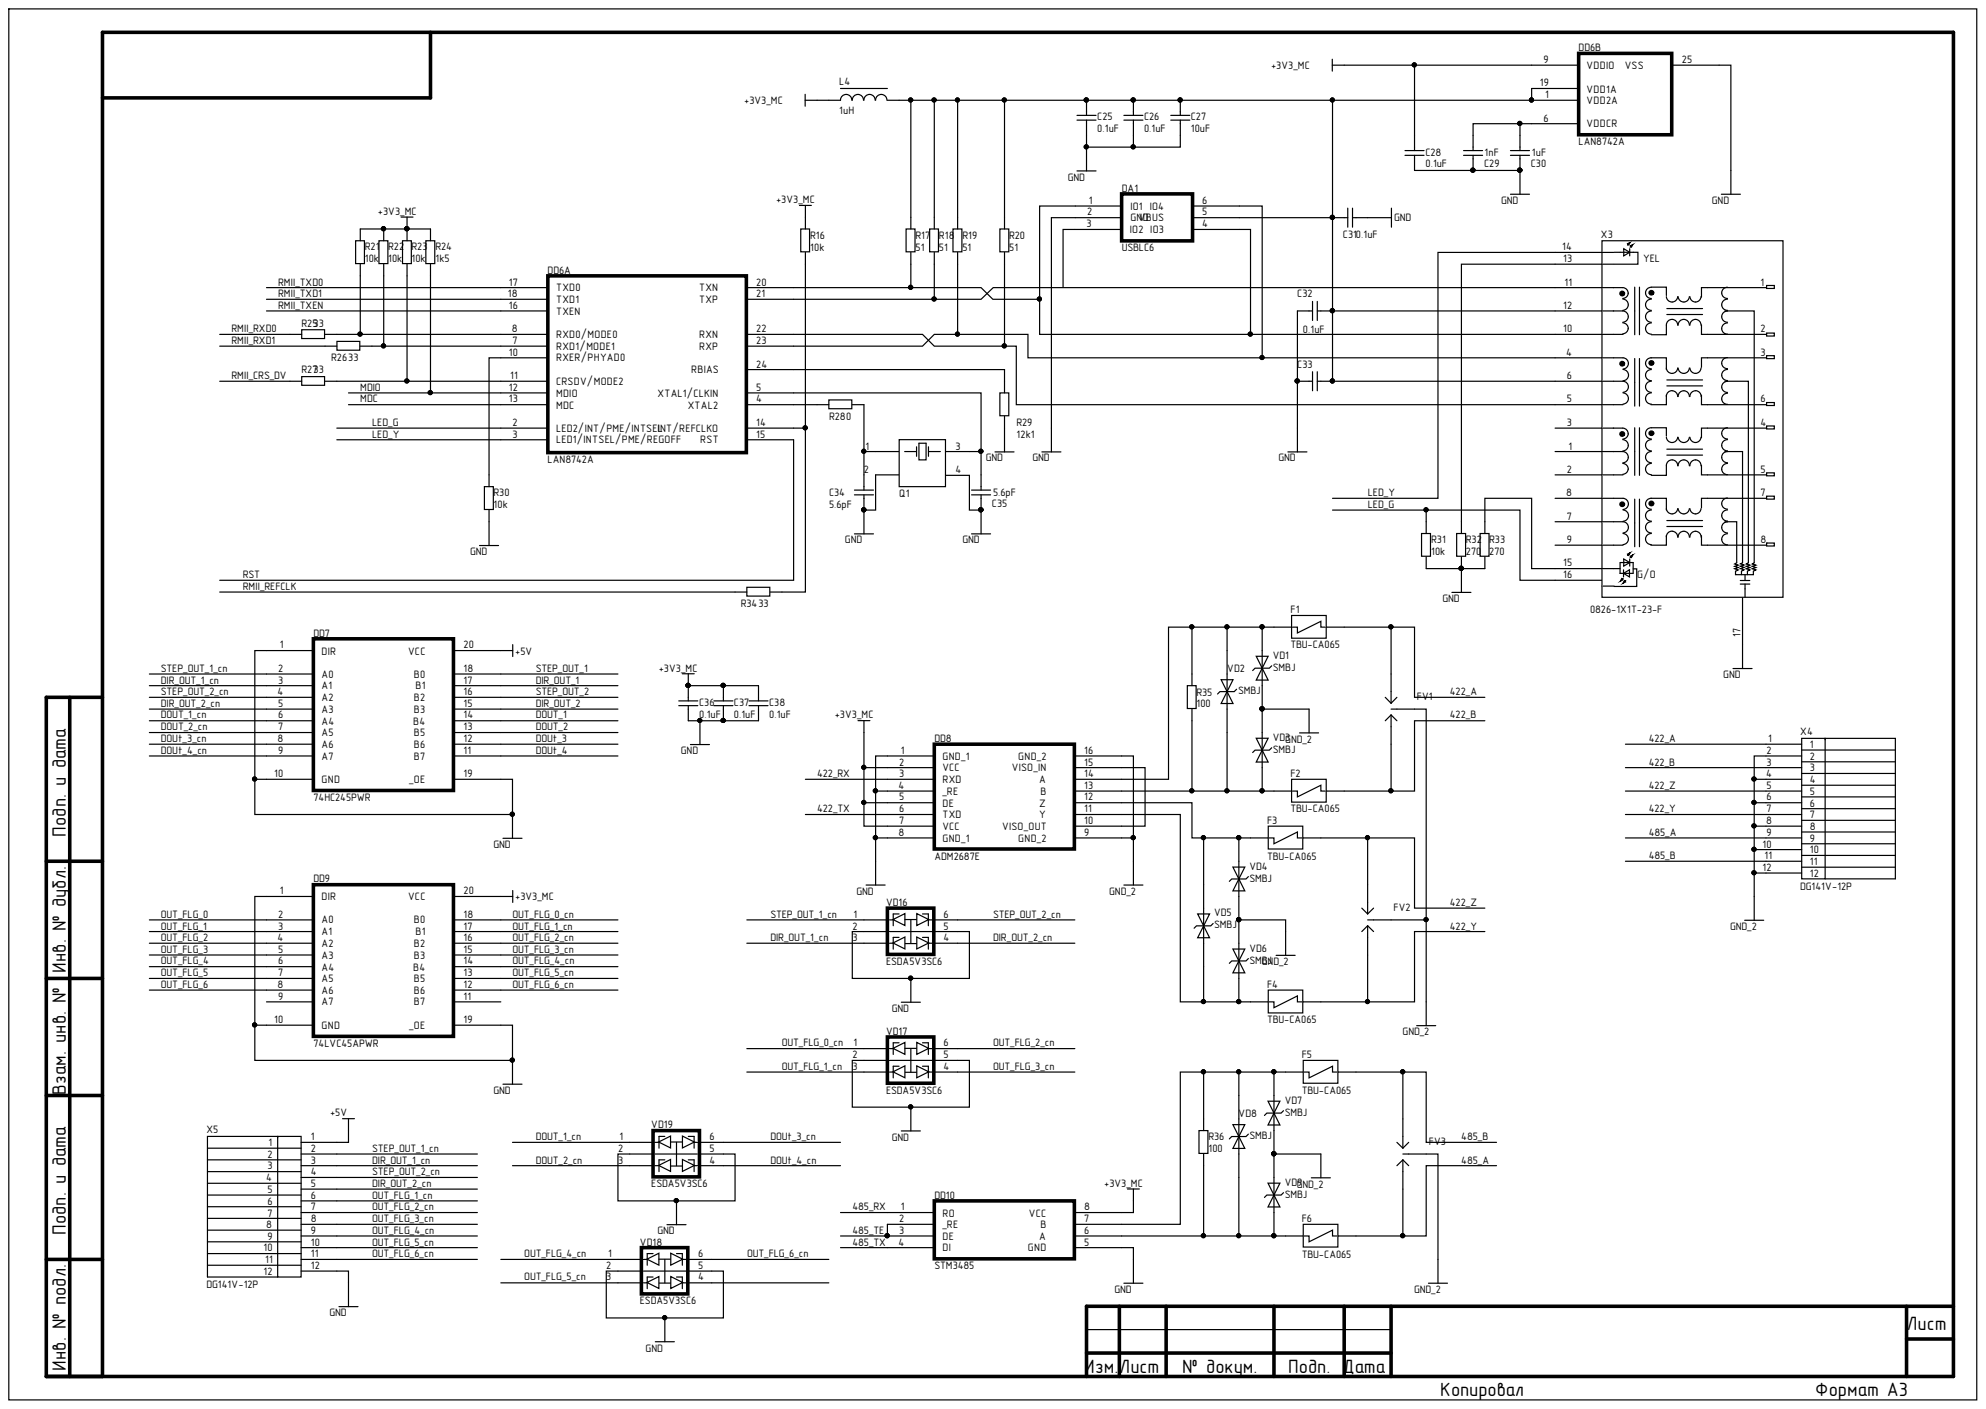
[picture p11: page 2]

RST

Инв. № подл. Инв. № дубл. Подп. и дата Взам. инв. № Подп. и дата

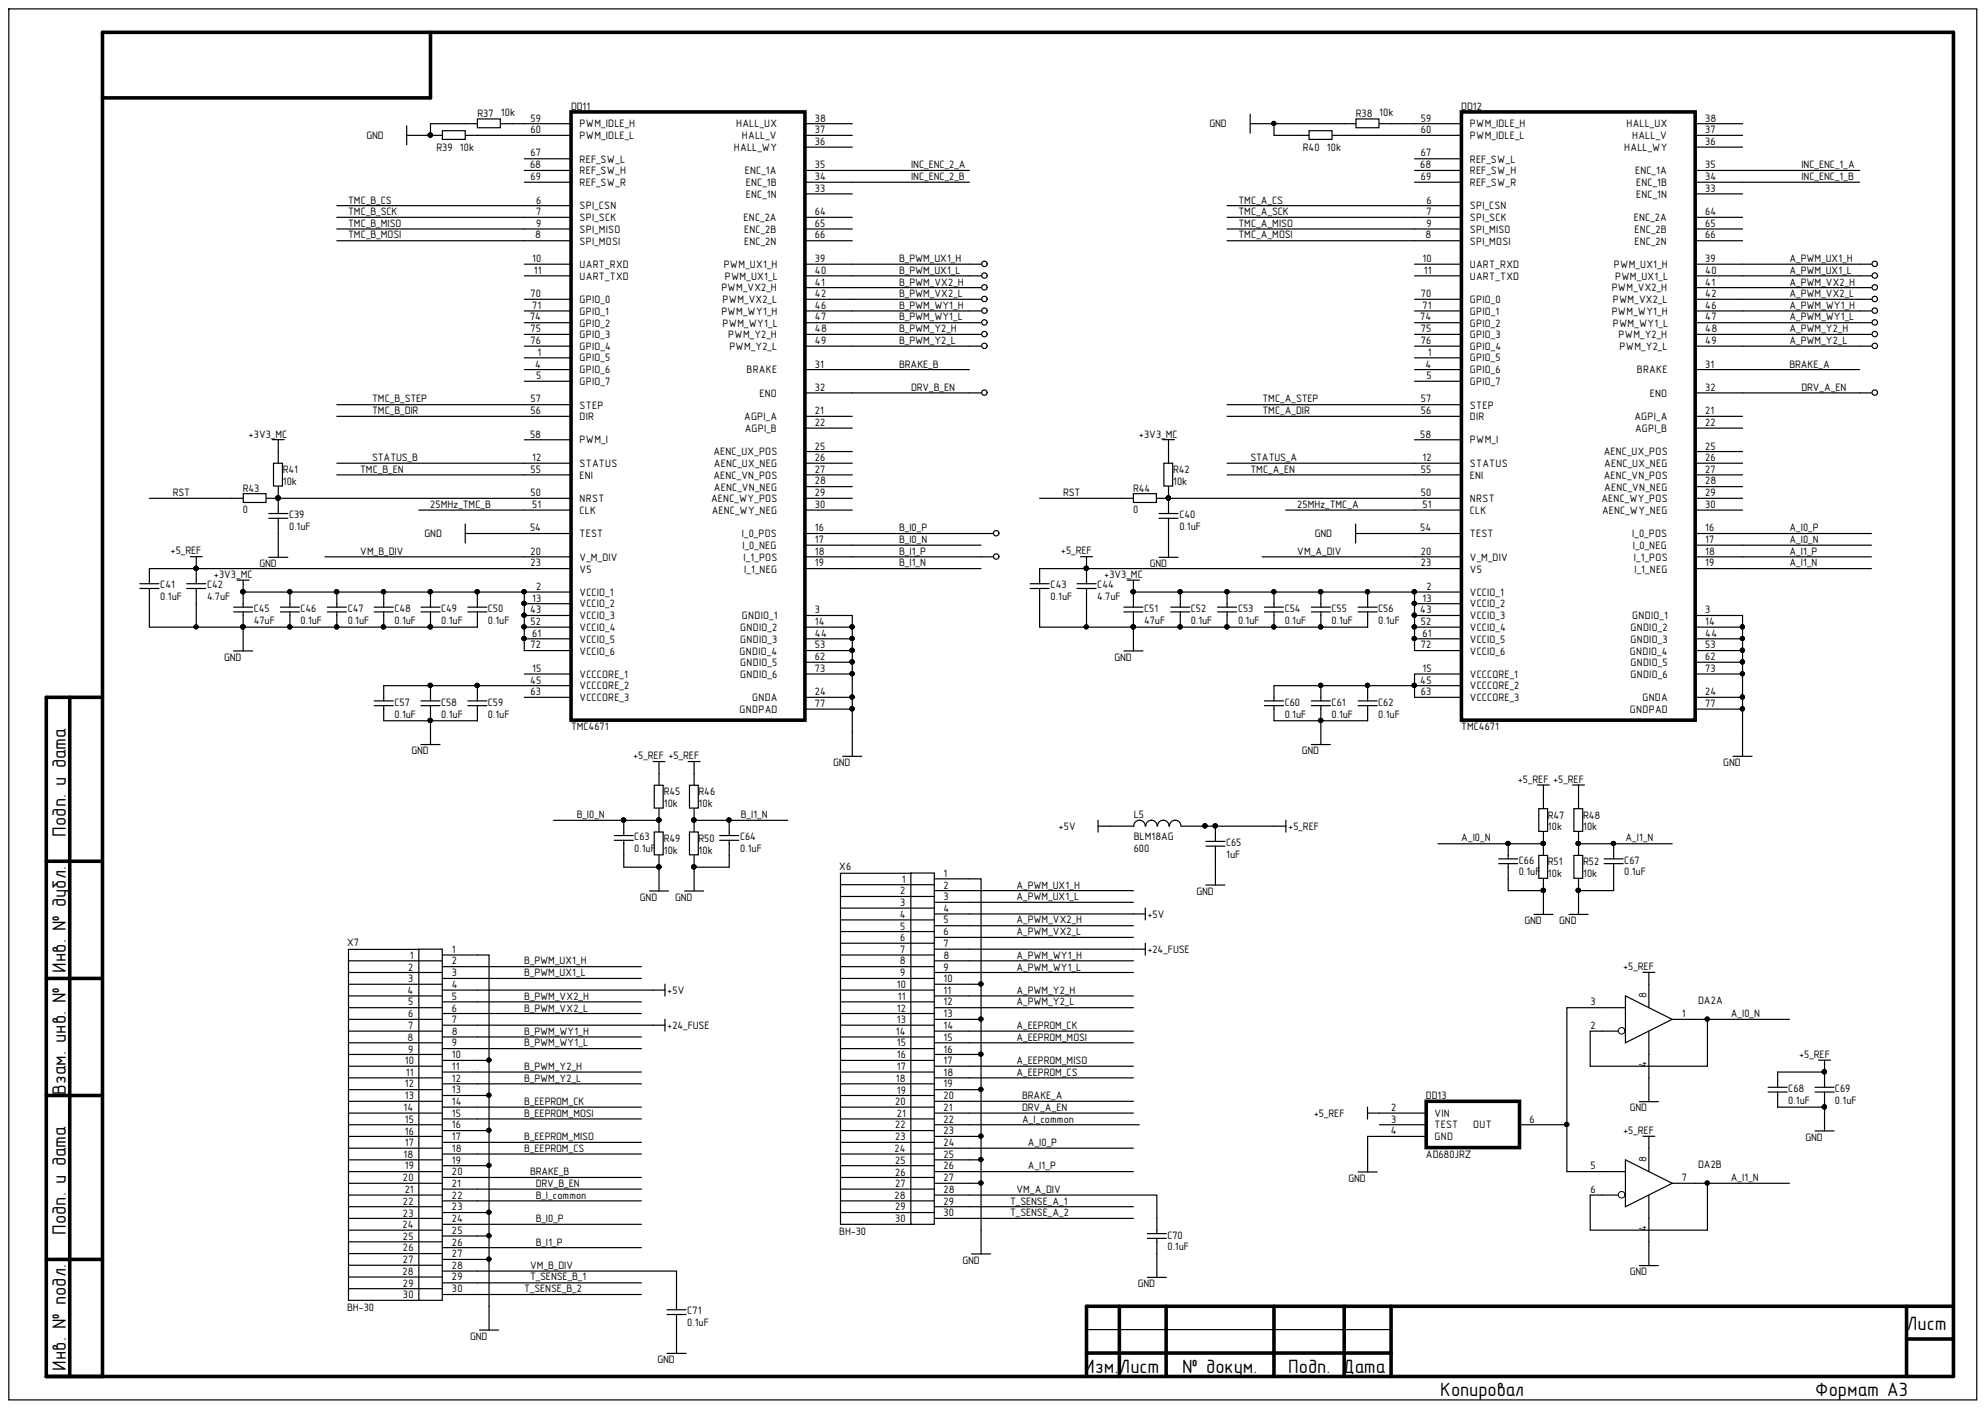
[picture p12: page 3]

Инв. № подл. Инв. № дубл. Подп. и дата Взам. инв. № Подп. и дата

26 | 26 27
27

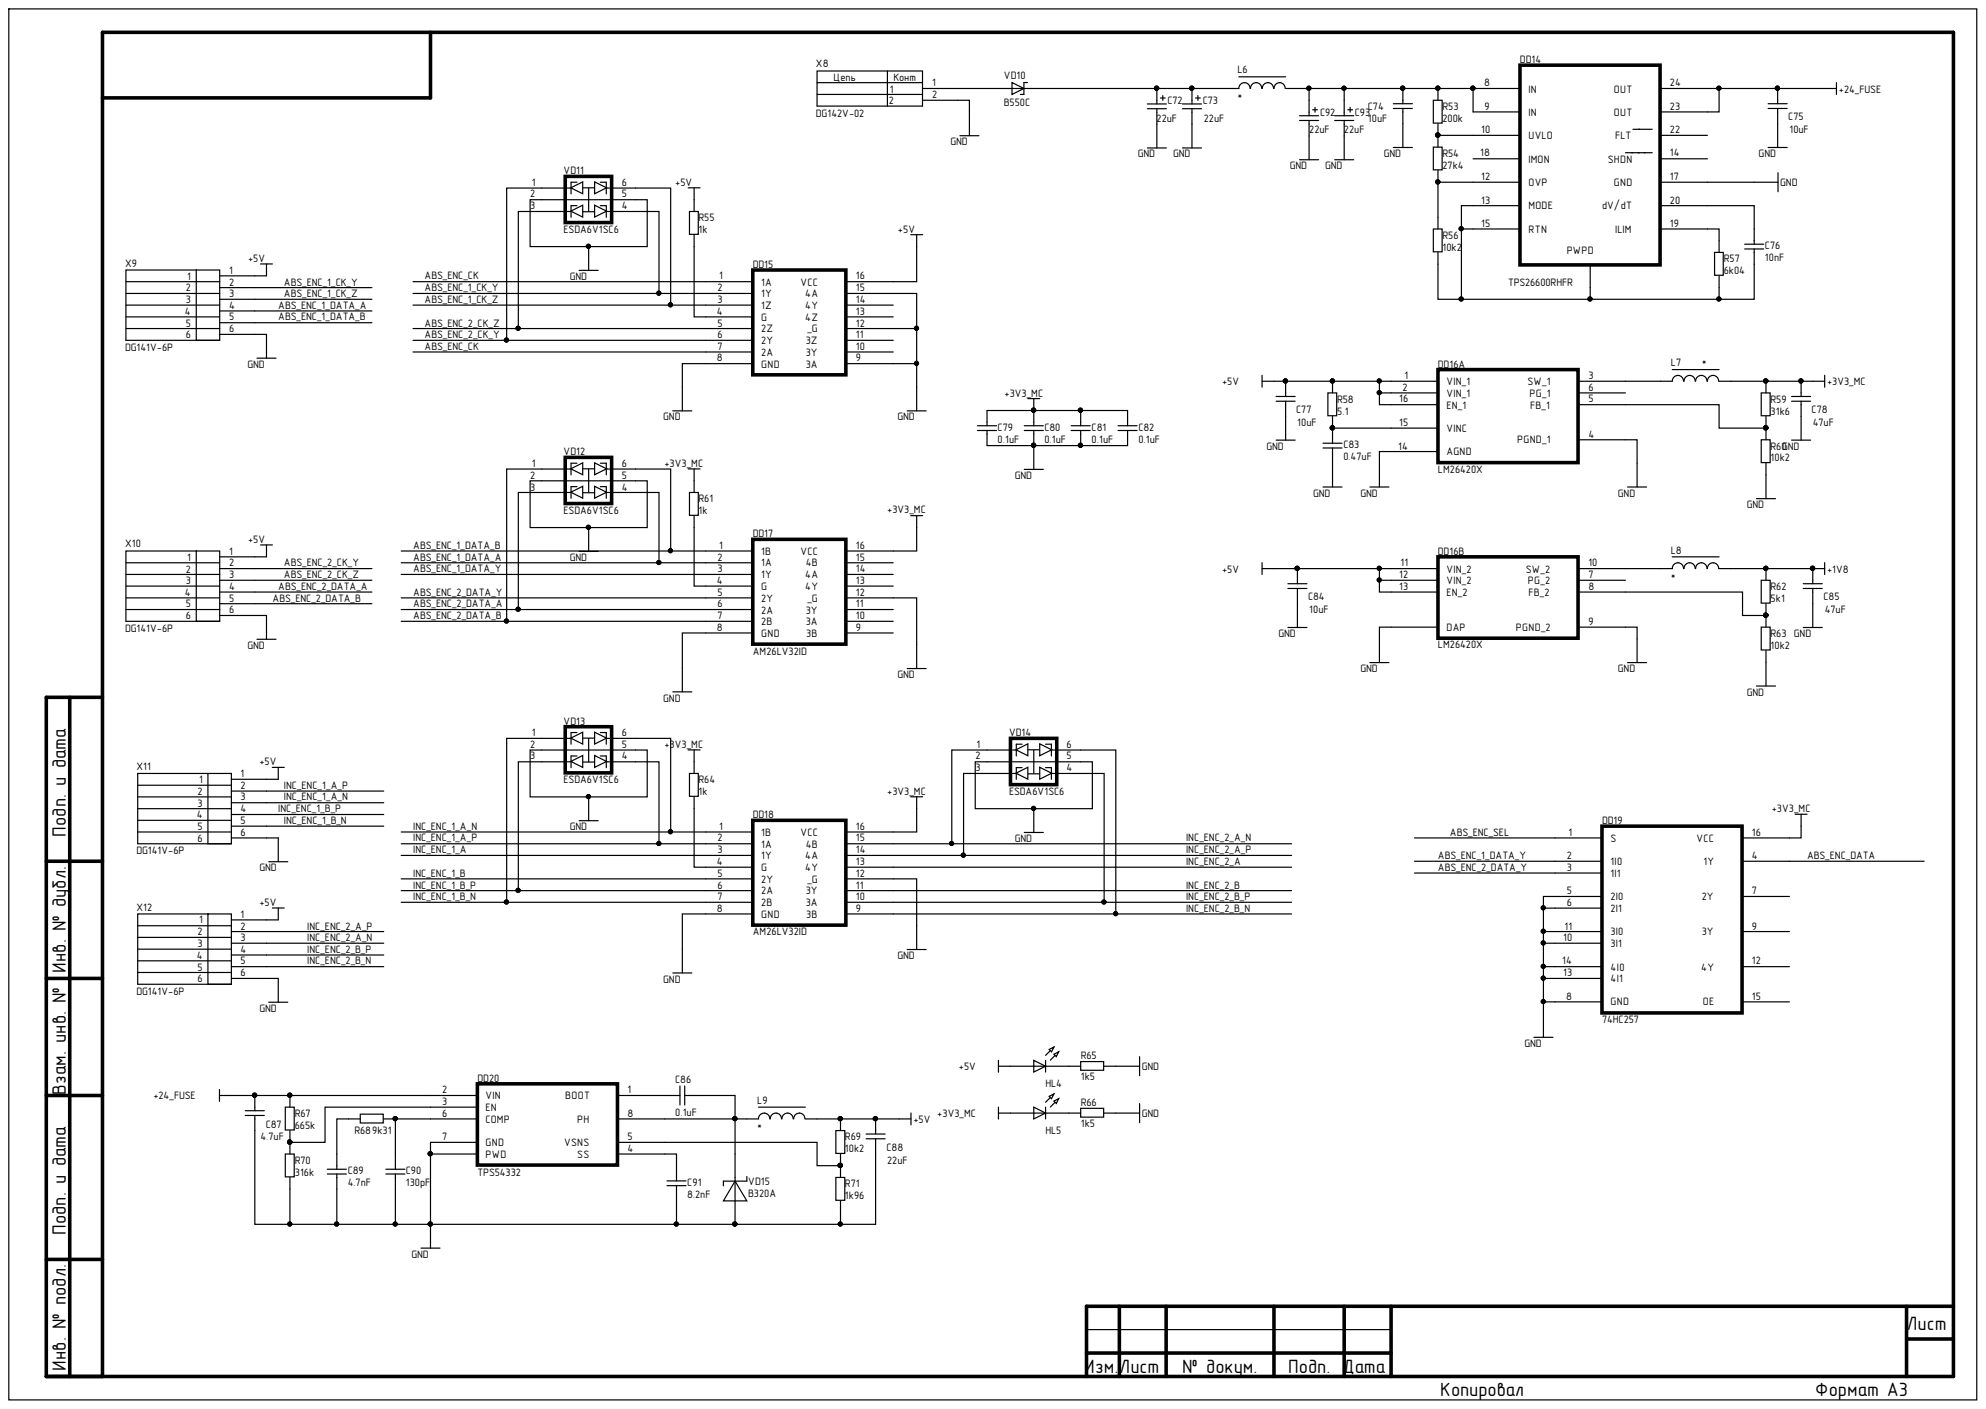
[picture p13: page 4]

Цепь | Конт

Инв. № подл. Инв. № дубл. Подп. и дата Взам. инв. № Подп. и дата

EN 3 | 0.1uF
COMP 6 GND 7
