UA1ZDC/StepDrive/(list of files, drawings)

Other design files:
StepDriveCont/SDC_v1.0/SDC.PrjPcb
StepDriveCont/SDC_v1.0/SDC_1.SchDoc
StepDriveCont/SDC_v1.0/SDC_2.SchDoc
StepDriveCont/SDC_v1.0/SDC_3.SchDoc
StepDriveCont/SDC_v1.0/SDC_4.SchDoc
StepDriveCont/SDC_v1.1/SDC_2.PrjPcb
StepDrivePwr/SDP_v1.0/DSP.PcbLib
StepDrivePwr/SDP_v1.0/DSP.SchLib
StepDrivePwr/SDP_v1.0/Schlib1.SchLib
StepDrivePwr/SDP_v1.0/SDP.PcbDoc
StepDrivePwr/SDP_v1.0/SDP.PrjPcb
StepDrivePwr/SDP_v1.0/SDP_1.SchDoc
StepDrivePwr/SDP_v1.0/SDP_2.SchDoc
StepDrivePwr/SDP_v1.1/DSP.PcbLib
StepDrivePwr/SDP_v1.1/DSP.SchLib
StepDrivePwr/SDP_v1.1/SDP.PcbDoc
StepDrivePwr/SDP_v1.1/SDP_1.SchDoc
StepDrivePwr/SDP_v1.1/SDP_2.PrjPcb
StepDrivePwr/SDP_v1.1/SDP_2.SchDoc
