UA1ZDC/StepDrive/(commit log)

2022-02-09 Add bill of materials
    [Бланк заказа.xlsx]
2022-02-09 Add gerber files
2022-02-10 Add SDP_v1.1
    Add guard for curent shunt input, change shunt type to one with higher common mode voltage.
    [DSP.PcbLib, DSP.SchLib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]
2022-02-12 Add GPO to SDC
    [SDP_BOM.xlsx, Бланк заказа_SDP.xlsx]
2022-02-12 Create ПРОТОКОЛ ОБМЕНА С КОНТРОЛЛЕРОМ АНТЕННЫ В ASCII КОДАХ.docx
2022-03-08 Add SDP_v1.1
    [SDC.PrjPcb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]
2022-11-11 Add Output Job
    [SDP_2.PrjPcb]
2022-11-11 Add Bill
    [SDP_BOM.xlsx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]
2022-11-29 assembly pdf
2022-12-08 Add libs, docs
    [SDC_1.SchDoc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]
2022-12-08 Relocate lib's
    [SDC_1.SchDoc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]
